enzoocorte/Planta-Ultrafiltracion/00_General_y_P_ID_Planta/01_Estructura_y_Montaje_Filtro/tanque permeado.jpg

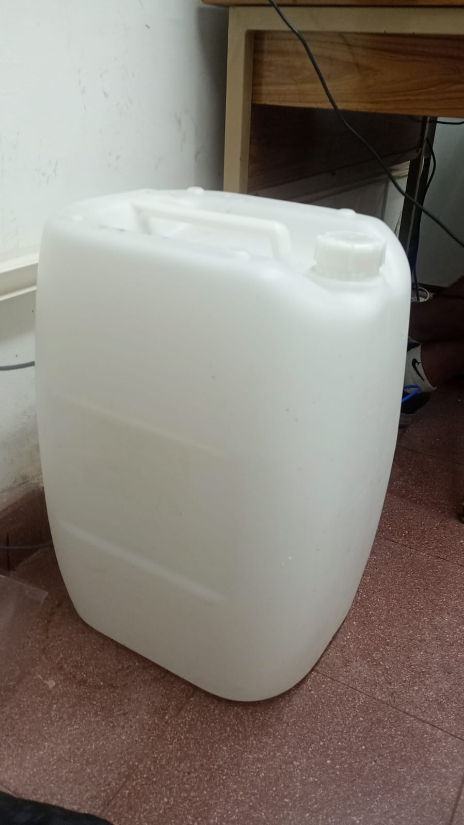
00_General_y_P_ID_Planta/01_Estructura_y_Montaje_Filtro/tanque permeado.jpg
