enzoocorte/Planta-Ultrafiltracion/03_Hito3_Reactor_Sedimentador_Agitador/03_Compras_y_Ferreteria_Hidraulica/Lista_Ferreteria_Mecanica_y_Electrica_Agitador_Hito3.md

# 🛒 LISTA MAESTRA CONSOLIDADA DE COMPRAS Y TALLER (PLANTEL COMPLETO)
## Hito 0, 1, 2 y 3: Skid 45x45, Hidráulica FX100, Sedimentador Inox y Control ESP32
**Proyecto:** Planta Piloto de Ultrafiltración UNSa — Meta: Puesta a punto 15 de Noviembre 2026  
**Referencia:** Auditoría Técnica Cruzada Antigravity & Argon (Octubre 2026)  
**Destinatarios:** Ing. Enzo Corte, Antonella Guitián & Owen Cañizares

---

## 🎯 1. Objetivo del Documento
Esta es la **hoja de ruta definitiva para compras y mostrador**. Contiene todos los componentes mecánicos, hidráulicos, eléctricos y de taller necesarios para armar el Skid de 45x45x45 cm, perforar el sedimentador de acero inoxidable AISI 304 e interconectar el cartucho Fresenius FX100 sin faltantes ni incompatibilidades de rosca.

---

## 📋 2. Planilla Maestra para Mostrador (Imprimir / Llevar al Celular)

### 🔩 SECCIÓN 1: Estructura del Maletín Skid (450 x 450 x 450 mm)
| Ítem | Componente | Cant. | Especificación Técnica | Dónde Comprar |
| :--- | :--- | :---: | :--- | :--- |
| **1.1** | **Base de madera marina** | 1 | Multilaminado fenólico marino **18 mm** cortado a **450 x 450 mm** (barnizado antihumedad). | Maderera / Easy |
| **1.2** | **Tubo estructural cuadrado** | 4 m | Tubo de acero al carbono **20 x 20 mm (chapa 1.2 mm)** para el marco cúbico. | Metalúrgica / Hierros Salta |
| **1.3** | **Chapa perforada** | 2 paños | Chapa de hierro o aluminio de **1.2 a 1.5 mm** perforada decorativa (450 x 450 mm). | Metalúrgica / Zinguería |
| **1.4** | **Puerta frontal transparente** | 1 placa | **Policarbonato compacto de 3 o 4 mm** (450 x 450 mm). *(No acrílico: no se quiebra por vibración)*. | Vidriería / Plásticos Salta |
| **1.5** | **Ferretería de puerta** | 1 juego | 2 bisagras metálicas tipo libro chicas + **1 traba rápida tipo baúl (*toggle latch*)**. | Ferretería industrial |
| **1.6** | **Tacos silentblock NEMA 34** | 4 | Tacos antivibratorios cilíndricos de goma **M5 macho-hembra** (20 mm alto). | Bulonera Salta |
| **1.7** | **Patas de goma del maletín** | 4 | Regatones o patas de goma con tornillo central (Ø 25–30 mm). | Bulonera Salta |
| **1.8** | **Manija de transporte** | 1 | Manija metálica rebatible robusta de maletín industrial. | Ferretería / Herrajes |
| **1.9** | **Abrazaderas del FX100** | 2 | Abrazaderas acolchadas con goma tipo clamps de **2" (50–55 mm)** para caño. | Sanitarios / Ferretería |
| **1.10**| **Tabique divisor interno** | 1 placa | Placa fenólica de 10-12 mm o PVC espumado (430 x 430 mm) para separar zona seca/húmeda. | Maderera / Taller |

---

### 🚰 SECCIÓN 2: Conexiones Hidráulicas, Válvulas y Dializador FX100
> [!IMPORTANT]
> **Llevar al mostrador:** El cartucho FX100, los manómetros P1/P2 y el caudalímetro YF-S401 para presentar las roscas y espigas en la mano.

| Ítem | Componente | Cant. | Especificación Técnica | Función en Planta |
| :--- | :--- | :---: | :--- | :--- |
| **2.1** | **Válvula de corte succión** | 1 | Válvula esférica de **1/2" Macho-Hembra (o H-H)** en bronce o acero inox. | Se enrosca al pasamuros del sedimentador para cortar flujo y desacoplar sin vaciar 25L. |
| **2.2** | **Pasamuros sedimentador** | 1 | Pasamuros de bronce o acero inox de **1/2"** con tuerca hexagonal ancha con brida. | Toma de succión en pared cilíndrica del sedimentador. |
| **2.3** | **Pasamuros de panel skid** | 3 | Pasamuros hidráulicos/neumáticos roscados de **1/4" BSP** (1 para retorno, 2 para panel skid). | Traspaso estanco de mangueras a través de las paredes. |
| **2.4** | **Pasamuros bidón permeado** | 1 | Pasamuros plástico de **1/2"** con canilla plástica o metálica de **1/2"**. | Salida dispensadora de agua tratada en bidón inferior. |
| **2.5** | **Niples entrerrosca** | 2 | Niple hexagonal de bronce de **1/4" Macho - 1/4" Macho**. | **Crítico:** Une la Tee hembra de P2 directo a la válvula de aguja hembra. |
| **2.6** | **Tees para manómetros** | 2 | Tee de bronce de **1/4" Hembra - Hembra - Hembra**. | Intercala los manómetros P1 y P2 en la línea de flujo. |
| **2.7** | **Bujes de reducción** | 2 | Buje de reducción de bronce de **1/2" Macho a 1/4" Hembra**. | Reducción inmediata a la salida del cabezal peristáltico. |
| **2.8** | **Bujes de manómetros** | 2 | Buje de reducción de **1/4" Macho a 1/8" Hembra** *(solo si los manómetros son rosca 1/8")*. | Adaptación según rosca inferior del manómetro Bourdon. |
| **2.9** | **Válvula de aguja** | 1 | Válvula de aguja de **1/4" Hembra - Hembra** (latón o acero inox). | Control fino de contrapresión y ajuste exacto de TMP en retentado. |
| **2.10**| **Espigas para manguera 1/4"** | 6 | Espiga de bronce rosca **1/4" Macho** para manguera de 6 mm int. | Conexión de tees, pasamuros y válvula de aguja. |
| **2.11**| **Espigas para manguera 1/2"** | 3 | Espiga de bronce rosca **1/2" Macho** para manguera de 12 mm int. | Conexión en válvula de corte y succión de bomba. |
| **2.12**| **Uniones dobles espiga** | 2 | Unión doble espiga-espiga de bronce o plástico de **1/2" (12 mm)**. | Empalme del tramo de silicona peristáltica con manguera de línea. |
| **2.13**| **Manguera bomba peristáltica**| 1 m | Tubo de **Silicona curada al platino o Norprene Ø int. 12 mm (pared ≥ 3 mm)**. | Tramo interno de rodillos MBP-2000 *(prohibido PVC cristal aquí)*. |
| **2.14**| **Manguera de línea 1/2"** | 2 m | Manguera atóxica flexible de PVC cristal o silicona Ø int. **12 mm**. | Succión desde sedimentador al maletín. |
| **2.15**| **Manguera de línea 1/4"** | 4 m | Manguera atóxica de silicona o PVC cristal Ø int. **6 mm**. | Circuito de permeado, retentado y manómetros. |
| **2.16**| **Manguera acople FX100** | 0.5 m | Tubo de silicona de **Ø int. 10 a 12 mm**. | Calza sobre los picos lisos Hansen (12 mm) del dializador FX100. |
| **2.17**| **Venteo/Tapón FX100** | 1 | Tapón de 1/2" o valvulita esférica miniatura de 1/4" con reducción. | Clausura/purga de aire del 2do puerto lateral de dializado del FX100. |
| **2.18**| **Sellador de roscas** | 1 pomo | **Sellador anaeróbico para roscas (Trabasil RM2 / Loctite 542 / Hidro 3)**. | Permite orientar P1 y P2 hacia el frente con cero goteo. |
| **2.19**| **Cinta teflón industrial** | 2 rollos| Cinta de teflón de alta densidad (carrete amarillo o rosa). | Sellado complementario de roscas cónicas. |
| **2.20**| **Abrazaderas y precintos** | 1 pack | 10 abrazaderas cremallera 1/2", 6 abrazaderas 1/4" + **10 precintos plásticos 100x2.5mm** (para YF-S401). | Sujeción estanca sin quebrar picos plásticos. |

---

### 🌪️ SECCIÓN 3: Tren Mecánico del Sedimentador (Hito 3)
| Ítem | Componente | Cant. | Especificación Técnica | Dónde Comprar |
| :--- | :--- | :---: | :--- | :--- |
| **3.1** | **Chumacera con Brida** | 1 | **Chumacera tipo KFL08 (para eje Ø 8 mm)** con 2 prisioneros allen. | Rodamientos Salta / Ituzaingó |
| **3.2** | **Acoplamiento Elástico** | 1 | Acople tipo spider / mandíbula **8 mm a 8 mm** (o según eje motor). | Rodamientos Salta / Mercado Libre |
| **3.3** | **Varilla de Eje Agitador** | 1 m | **Varilla redonda calibrada de Acero Inox AISI 304 Ø 8 mm (tolerancia h9)**. | Bulonera Salta / Aceros |
| **3.4** | **Placa Sándwich de Grilón** | 1 placa | Placa de **Grilón / Nylon de 120 x 120 mm (espesor 8 a 10 mm)**. | Bulonera Salta / Plásticos |
| **3.5** | **Separadores de Torreta** | 4 | Separadores o espárragos roscados **M6 x 50 mm** de acero cincado o inox. | Bulonera Salta |
| **3.6** | **Tornillería Inox Tapa** | 1 juego | Tornillos M5 y M6 con arandelas planas, growers y tuercas autofrenantes en AISI 304. | Bulonera Salta |
| **3.7** | **Arandelas respaldo pasamuros**| 4 | Arandelas planas de **Acero Inox AISI 304 de ala ancha** para bulón de 1/2" y 3/4". | Bulonera Salta |
| **3.8** | **Plancha de goma para juntas** | 1 retazo| Goma de **Silicona Sanitaria o EPDM espesor 3 mm** (para cortar juntas curvas). | Bulonera Salta / Sanitarios |

---

### ⚡ SECCIÓN 4: Electricidad, Control e Inmunidad EMI
| Ítem | Componente | Cant. | Especificación Técnica | Dónde Comprar |
| :--- | :--- | :---: | :--- | :--- |
| **4.1** | **Gabinete estanco para lógica**| 1 | Caja estanca plástica IP65 de **150 x 110 x 70 mm** con tapa transparente/opaca. | Casa de Electricidad Salta |
| **4.2** | **Fuente conmutada DC** | 1 | Fuente switching **12V DC (8 a 10A)** tipo panel con bornera. | Electrónica / Megatone |
| **4.3** | **Driver MOSFET Agitador** | 1 | Módulo **BTS7960 (IBT-2 de 43A)** con disipador macizo. | Electrónica / Mercado Libre |
| **4.4** | **Conector circular industrial** | 1 par | Conector tipo aviación **GX16 de 4 pines** (1 chasis hembra + 1 aéreo macho). | Electrónica Salta |
| **4.5** | **Cable tipo taller envainado** | 3 m | Manguera redonda flexible negra de **4 x 1.0 mm² o 4 x 1.5 mm²**. | Casa de Electricidad Salta |
| **4.6** | **Entrada 220V de chasis** | 1 | Conector tipo interlock C14 con **portafusible y tecla luminosa bipolar**. | Electrónica Salta |
| **4.7** | **Portafusible secundario 24VAC**| 1 | Portafusible aéreo o de chasis + **2 fusibles de vidrio de 6A o 8A (lentos / Time-Lag)**. | Electrónica Salta |
| **4.8** | **Prensaestopas de panel** | 6 | Prensaestopas plásticos de nylon: **2x PG7** (sensores tapa) + **4x PG9/PG11** (caja estanca). | Casa de Electricidad Salta |
| **4.9** | **Capacitor VIN ESP32** | 1 | Capacitor electrolítico de **470 µF / 25V** (reservorio anti-brownout Wi-Fi). | Casa de Electrónica |
| **4.10**| **Capacitor entrada BTS7960** | 1 | Capacitor electrolítico de **1000 µF / 25V** (absorción de picos del agitador). | Casa de Electrónica |
| **4.11**| **Capacitores cerámicos anti-ruido**| 3 | Capacitores cerámicos multicapa de **100 nF (0.1 µF / 50V)** (motor, boya, VIN). | Casa de Electrónica |
| **4.12**| **Resistencias de protección** | 2 c/u | Resistencia de **2.2 kΩ** (pull-up boya) + Resistencia de **470 Ω** (en serie a GPIO 32). | Casa de Electrónica |

---

### 🛠️ SECCIÓN 5: Herramientas Críticas de Taller (Para Inox 304)
| Ítem | Herramienta | Cant. | Especificación Técnica | Uso Exclusivo |
| :--- | :--- | :---: | :--- | :--- |
| **5.1** | **Mecha escalonada de Cobalto** | 1 | **Mecha escalonada cónica HSS-Co (M35 con 5% Cobalto) de 4 a 22 mm**. | Perforación perfecta y sin rebaba del Inox 304 a 350-400 RPM. |
| **5.2** | **Mecha guía de Cobalto** | 1 | Mecha helicoidal HSS-Co de **Ø 3.2 mm o 4.0 mm**. | Agujero guía previo al escalón en la chapa del sedimentador. |
| **5.3** | **Aceite de corte pesado** | 1 frasco| Aceite para roscado/corte de metales pesados o aceite de motor SAE 30/40. | Lubricación constante del filo en inox (evita vitrificación). |

---

## 📍 3. Comercios Recomendados en Salta Capital

1. **Bulonería y Plásticos Técnicos (Grilón, bulonería inox AISI 304, silentblocks, mecha cobalto):**
   * **Bulonera Salta:** Av. San Martín / Av. Chile.
2. **Rodamientos y Mecánica (Chumacera KFL08, acople flexible, varilla calibrada 8 mm):**
   * **Rodamientos Salta:** Av. San Martín y Pellegrini.
   * **Casa del Rodamiento:** Calle Ituzaingó y Pellegrini.
3. **Hidráulica y Sanitarios (Válvulas esféricas, válvula de aguja, tees de bronce, pasamuros, Trabasil):**
   * **Sanitarios Pieve / Sanitarios San Martín / Ferretería Central:** Av. San Martín / Pellegrini.
4. **Electricidad y Gabinetes (Cajas IP65 Roker/Genrod, térmicas, prensaestopas, cable TPR):**
   * **Electro Salta / Megatone Materiales Eléctricos:** Calle Pellegrini / Urquiza.
5. **Componentes Electrónicos (BTS7960, GX16, capacitores, fusibles):**
   * **Microelectrónica Salta / Megatone Componentes:** Calle Alvarado / Urquiza.
