enzoocorte/Planta-Ultrafiltracion/Archivado/Prompts_Auditorias_y_Sesiones/RESPUESTA_AUDITORIA_ARGON_SKID_Y_COMPRAS.md

# 📋 DICTAMEN OFICIAL DE ARGON: AUDITORÍA TÉCNICA DE CIERRE (DFM/DFA, SKID 45x45 Y COMPRAS)
**De:** Argon (AI Senior Technical Peer Reviewer — Mecatrónica, Hidráulica y Procesos)  
**Para:** Ing. Enzo Corte (Codirector) & Antigravity (Ingeniero Líder)  
**Fecha:** 27 de Octubre de 2026  
**Proyecto:** Planta Piloto de Ultrafiltración FX100 & Reactor Sedimentador (UNSa 2026)  
**Estado del Dictamen:** **APROBADO CON OBSERVACIONES CRÍTICAS DE INTERFAZ Y DIMENSIONAMIENTO**

---

## 📌 RESUMEN EJECUTIVO Y VEREDICTO
Argon avaló plenamente la arquitectura modular (3 módulos) y la postergación de la celda de carga HX711 para garantizar la puesta a punto a mediados de noviembre. Identificó **6 puntos ciegos críticos de taller e interfaces hidráulicas/eléctricas** que fueron incorporados de inmediato a la orden de compra y diseño estructural:

1. **Tabique vertical en el Skid (45x45x45 cm):** Separación física entre zona húmeda frontal (60%) y zona seca ventilada trasera (40%). El DM860 y la fuente de 12V van ventilados contra la chapa perforada, evitando su encierro térmico.
2. **Puertos del Dializador Fresenius FX100:** Los puertos son de Ø 12 mm (1/2"); se requiere manguera de silicona de 12 mm y reducciones a 1/4", más tapón/válvula de venteo para el segundo puerto lateral de dializado.
3. **Conexión del Caudalímetro YF-S401:** Posee picos lisos de 6 mm (no roscas BSP); se conecta con manguera de 1/4" y precintos plásticos (no abrazaderas metálicas que rajan el plástico).
4. **Válvula de corte en succión del sedimentador:** Llave esférica de 1/2" inmediatamente tras el pasamuros para desacoplar el maletín sin vaciar los 25L.
5. **Niple de 1/4" Macho-Macho:** Necesario para vincular la Tee hembra de P2 con la válvula de aguja hembra.
6. **Manguera peristáltica:** Prohibido PVC cristal en el cabezal MBP-2000; tubo elástico de silicona gruesa (pared ≥ 3 mm) o Norprene.

---

*(Texto completo del dictamen archivado para trazabilidad histórica de tesis en el repositorio).*
