enzoocorte/Planta-Ultrafiltracion/Curso_Congreso_Quimica/GUIA_LABORATORIO_IMPRIMIR_CONEIQ_2026.docx

XXIX CoNEIQ Salta 2026 — Taller de Tratamiento de Aguas

GUÍA RÁPIDA DE OPERACIÓN EN MESADA (VASOS DE 1000 mL / 100% AGUA DE RED)
Audiencia: 30 Inscriptos (5 Brigadas de 6 Alumnos + Vaso Control Docente) | Docentes: Dr. Emilio Almazán & Ing. Enzo Corte

1. CHECKLIST PREVIO AL ENSAYO (100% AGUA DE RED — SIN DESTILADA)

- Rotular 6 vasos de precipitado de 1000 mL (1 L): V1 (Docente), V2 a V4 (Baja Turbidez) y V5 a V6 (Alta Turbidez). Cargar con 1000 mL de agua de red c/u.
- Pesar y dispersar arcilla tamizada (<45 um): 1.00 g en V2, V3, V4 (Baja Turbidez, ~120 NTU) | 4.00 g en V1, V5, V6 (Alta Turbidez, ~450 NTU).
- Preparar Stock de Sulfato al 1.0% p/v en agua de red: Disolver 2.50 g de sulfato puro en 250 mL de agua de red (10 mg/mL).
- Biocoagulante de Penca (Hidrogel suave): Hidratar cubos 15 min en agua y dar 6 pulsos suaves de 2 s. Pesar en balanza: 0.50 g (V3), 1.80 g (V4) y 0.60 g (V6).
- Acondicionar Turbidímetro HANNA: verificar cubetas limpias con pañuelo tissue y patrones a mano.

2. CUADRO MAESTRO DE DOSIFICACIÓN (VASOS DE 1000 mL)

Vaso | Asignación | Matriz (1 L) | Tratamiento | Dosis Efectiva | ¿Cuánto agregar al Minuto 0?
V1 | Docentes (Control) | 1000 mL + 4.0 g arcilla | Blanco (Control) | 0 mg/L | Nada (0 mL)
V2 | Brigada 1 (6 alumnos) | 1000 mL + 1.0 g arcilla | Sulfato de Aluminio | 20 mg/L | 2.0 mL de stock 1% (2000 uL)
V3 | Brigada 2 (6 alumnos) | 1000 mL + 1.0 g arcilla | Penca (Opuntia) | 0.5 g/L | 0.50 g de hidrogel fresco
V4 | Brigada 3 (6 alumnos) | 1000 mL + 1.0 g arcilla | Penca (SOBREDOSIS) | 1.8 g/L | 1.80 g de hidrogel (¡Visual!)
V5 | Brigada 4 (6 alumnos) | 1000 mL + 4.0 g arcilla | Sulfato de Aluminio | 40 mg/L | 4.0 mL de stock 1% (4000 uL)
V6 | Brigada 5 (6 alumnos) | 1000 mL + 4.0 g arcilla | Penca (Opuntia) | 0.6 g/L | 0.60 g de hidrogel fresco

3. CRONOGRAMA OPERATIVO DE CORRIDA (16 MINUTOS EXACTOS)

• MIN 00:00 - 01:00 (150 RPM — MEZCLA RÁPIDA): Encender las 6 paletas. Las brigadas agregan SIMULTÁNEAMENTE sus reactivos. Dispersión macromolecular y neutralización instantánea.

• MIN 01:00 - 06:00 (25-30 RPM — MEZCLA LENTA): Bajar velocidad a 25-30 RPM. Floculación ortocinética: observar macroflóculos en V3 y V6 vs flóculos densos en V2 y V5, y la opacidad lechosa en V4.

• MIN 06:00 - 16:00 (0 RPM — SEDIMENTACIÓN ESTÁTICA): Cortar motor a 0 RPM. Subir suavemente las paletas. Reposo estático durante 10 minutos (precipitación según Ley de Stokes).

• MIN 16:00 (MUESTREO Y MEDICIÓN CON TURBIDÍMETRO HANNA): Tomar muestra a 2 cm de profundidad con pipeta/jeringa (no tocar el fondo). Limpiar celda con tissue, alinear muesca y presionar READ.

4. PLANILLA DE REGISTRO EN MESADA (PARA COMPLETAR A MANO DURANTE EL ENSAYO)

Vaso | Asignación | Tratamiento | Dosis | Turb. Inicial (Ti) | Turb. Final (Tf) | Remoción RT % | pH Inic. | pH Fin. | Aspecto Visual
V1 | Docentes | Blanco (Control) | 0 mg/L
V2 | Brigada 1 | Sulfato Aluminio | 20 mg/L
V3 | Brigada 2 | Penca (Opuntia) | 0.5 g/L
V4 | Brigada 3 | Penca SOBREDOSIS | 1.8 g/L
V5 | Brigada 4 | Sulfato Aluminio | 40 mg/L
V6 | Brigada 5 | Penca (Opuntia) | 0.6 g/L

5. PREGUNTAS DISPARADORAS Y CHULETA TEÓRICA PARA EL DOCENTE

• ¿Por qué V4 (sobredosis en baja turbidez) clarificó mucho peor que V3?: Impedimento estérico y saturación coloidal: el exceso de mucílago recubre individualmente cada partícula de arcilla. Al no haber sitios activos libres, las partículas se repelen y no forman puentes, manteniéndose en suspensión.

• ¿Por qué el sulfato bajó el pH y la penca no?: El catión Al3+ se hidroliza liberando iones H+ al medio (consume alcalinidad natural del agua). La penca actúa como biopolímero por puente molecular sin alterar la química ácida-base (pH neutro).

• ¿Por qué prehidratamos la penca 15-20 min?: Permite el hinchamiento osmótico (swelling) del mucílago, relajando las cadenas para extraer el hidrogel íntegro con pulsos suaves sin romperlas covalentemente por alto cizallamiento.

• Acondicionamiento para el Jueves (Ultrafiltración): Sifonar con pipeta 600 a 700 mL de sobrenadante de V2, V3 y V5 + una alícuota de agua cruda (400 NTU). Guardar en botellas rotuladas para alimentar la Planta FX100.
