enzoocorte/Planta-Ultrafiltracion/Curso_Congreso_Quimica/PLANIFICACION_CURSO_CONEIQ_2026.docx

XXIX CoNEIQ Salta 2026 — Congreso Nacional de Estudiantes de Ingeniería Química

PLANIFICACIÓN INTEGRAL DE CURSO / TALLER TEÓRICO-PRÁCTICO
"Tratamiento Avanzado y Sustentable de Aguas: Sinergia entre Biocoagulantes Naturales (Opuntia ficus-indica) y Separación por Membranas de Ultrafiltración (UF)"

Docentes / Disertantes: Dr. Ing. Emilio Almazán & Ing. Enzo Corte (UNSa - INIQUI - CONICET)
Audiencia: 30 Estudiantes inscriptos (5 Brigadas de 6 alumnos + 1 Vaso Control Docente)
Recursos: 6 Vasos de precipitado de 1000 mL (1 L) | 100% Agua de Red local (sin requerimiento de agua destilada)

1. RESUMEN EJECUTIVO Y DINÁMICA DE COORDINACIÓN

- ¿Por qué 3 horas el Miércoles?: 3 horas completas son indispensables. Con 30 estudiantes divididos en brigadas, el trabajo involucra conformación de grupos, pesada y dispersión individual de arcilla en los vasos de 1 Litro, extracción suave del hidrogel de penca y stock de sulfato, corrida del Jar Test (16 min), nefelometría Hanna, pH, carga colaborativa de datos y envasado de sobrenadantes para el jueves.
- ¿Cómo estructurar el Jueves (3 h)?: División pedagógica 50% Aula / 50% Planta: Bloque 1 (14:00 - 15:15) Clase magistral de Membranas con el Dr. Emilio Almazán (fuerzas impulsoras, analogía Darcy-Ohm, Hermia, Fibra Hueca vs Plana). Bloque 2 (15:15 - 17:00) Operación en Planta Piloto FX100 con Enzo Corte, filtrando primero el agua clarificada con penca (TMP plana y estable) y luego el agua cruda (salto de presión por colmatación), retrolavado y cálculo de FRR%.

2. CRONOGRAMA MAESTRO DEL CURSO

- Martes 20/10 (14:00 - 17:00): Problemática hídrica en zonas áridas y tratamientos convencionales. Actividad grupal de diagnóstico. Introducción a biopolímeros naturales.
- Miércoles 21/10 (08:00 - 11:00): Laboratorio Experimental de Clarificantes. Preparación de matrices acuosas de 1 L en agua de red, extracción de Opuntia ficus-indica por bajo cizallamiento, corrida del Jar Test de 16 minutos, medición con turbidímetro Hanna y almacenamiento de muestras.
- Jueves 22/10 (14:00 - 17:00): Teoría de Procesos de Separación por Membranas (Emilio Almazán) y Taller Experimental en Planta Piloto FX100 con SCADA Web / ESP32 (Enzo Corte).

3. LABORATORIO DE CLARIFICACIÓN: JAR TEST EN VASOS DE 1000 mL (MIÉRCOLES)

3.1. ¿Por qué hacemos la Prehidratación Estática de la Penca (15-20 min)?

FUNDAMENTO REOLÓGICO: En el cladodio fresco poscosecha, el mucílago está confinado en conductos laticíferos y células mucilaginosas en forma de gel semiseco concentrado. Al sumergir los dados en agua durante 15-20 min ocurre un hinchamiento osmótico (swelling) con ganancia de masa del ~50%. Esto relaja las cadenas macromoleculares de ácido galacturónico de las paredes celulares de celulosa y lignina, permitiendo que bastaran 6 pulsos suaves de 2 segundos para liberar el hidrogel íntegro. Si se licuara en seco o sin prehidratar, se requeriría un cizallamiento violento que fracturaría covalentemente las cadenas (despolimerización mecánica), arruinando su poder floculante.

3.2. Cuadro Comparativo: Sulfato de Aluminio vs. Penca (Opuntia ficus-indica)

Criterio Técnico | Sulfato de Aluminio Puro [Al2(SO4)3] | Penca de Tuna (Opuntia ficus-indica)
Mecanismo Dominante | Neutralización de carga y barrido: Cationes Al3+ comprimen doble capa y precipitan como hidróxido amorfo Al(OH)3. | Puente polimérico (Bridging): Cadenas largas macromoleculares con grupos -OH y -COO- que atrapan coloides simultáneamente.
Efecto sobre el pH | Ácido (Delta pH aprox -1.0): Se hidroliza liberando iones H+ y consume la alcalinidad natural del agua. | Neutro (Delta pH aprox 0): Polielectrolito de origen vegetal; no altera el equilibrio ácido-base del afluente.
Naturaleza del Lodo | Químico, voluminoso, gelatinoso, de difícil deshidratación física y con trazas de aluminio neurotóxico. | Biológico, compacto, de deshidratación rápida, 100% biodegradable y compostable para suelos agrícolas.
Efecto de Sobredosis | Inversión de carga positiva (+): Vuelve a dispersar los coloides y acidifica peligrosamente el agua. | Impedimento estérico: El mucílago satura cada coloide individualmente, impidiendo que formen puentes. Deja agua turbia y con DQO soluble.
Salinidad / TDS | Aporta aniones sulfato (SO4=) y aumenta los sólidos disueltos totales y conductividad. | No aporta sales minerales; mantiene la conductividad basal del agua de red.

3.3. Cuadro Maestro de Dosificación en Vasos de 1000 mL (1 Litro de Agua de Red)

Audiencia de 30 estudiantes organizada en 5 brigadas activas de 6 alumnos + 1 Vaso Control Docente. El ensayo se realiza 100% en agua de red.

Vaso | Asignación | Matriz (1 L) | Tratamiento | Dosis Efectiva | ¿Cuánto agregar al Min 0?
V1 | Docentes (Control) | 1000 mL + 4.0 g arcilla (~450 NTU) | Blanco (Control) | 0 mg/L | Nada (0 mL)
V2 | Brigada 1 (6 alumnos) | 1000 mL + 1.0 g arcilla (~120 NTU) | Sulfato de Aluminio | 20 mg/L | 2.0 mL stock 1% (2000 uL)
V3 | Brigada 2 (6 alumnos) | 1000 mL + 1.0 g arcilla (~120 NTU) | Penca (Opuntia) | 0.5 g/L | 0.50 g de hidrogel fresco
V4 | Brigada 3 (6 alumnos) | 1000 mL + 1.0 g arcilla (~120 NTU) | Penca (SOBREDOSIS) | 1.8 g/L | 1.80 g de hidrogel (¡Visual!)
V5 | Brigada 4 (6 alumnos) | 1000 mL + 4.0 g arcilla (~450 NTU) | Sulfato de Aluminio | 40 mg/L | 4.0 mL stock 1% (4000 uL)
V6 | Brigada 5 (6 alumnos) | 1000 mL + 4.0 g arcilla (~450 NTU) | Penca (Opuntia) | 0.6 g/L | 0.60 g de hidrogel fresco

IMPACTO VISUAL EN EL LABORATORIO: Al ubicar la sobredosis de penca en Baja Turbidez (Vaso 4), se genera un contraste pedagógico instantáneo contra el Vaso 3 (ambos parten del agua con 120 NTU): mientras V3 queda cristalino (<3 NTU), V4 queda notablemente lechoso y turbio debido a la reestabilización coloidal.

3.4. Cronómetro Operativo de Corrida (Ciclo de 16 Minutos)

- Min 00:00 - 01:00 (Mezcla Rápida a 150 RPM): Encender las paletas. Las brigadas agregan simultáneamente los reactivos en V2 a V6. Dispersión macromolecular y desestabilización instantánea.
- Min 01:00 - 06:00 (Mezcla Lenta a 25-30 RPM): Reducir agitación. Crecimiento ortocinético de macroflóculos por colisiones de Smoluchowski sin superar la tensión de corte que rompería los flóculos.
- Min 06:00 - 16:00 (Sedimentación Estática a 0 RPM): Apagar el motor y subir suavemente las paletas. Reposo estático de 10 minutos (precipitación por Ley de Stokes).
- Min 16:00 (Muestreo y Nefelometría Hanna): Tomar muestra a 2 cm de profundidad con pipeta/jeringa (sin perturbar el sedimento del fondo). Medir turbidez en turbidímetro Hanna HI93703 y registrar pH.
- Acondicionamiento para el Jueves: Sifonar con pipeta 600 a 700 mL de sobrenadante de V2, V3 y V5, y guardar una muestra de agua cruda (400 NTU) en botellas rotuladas para la ultrafiltración.

4. PROCESOS DE MEMBRANA Y PLANTA PILOTO DE ULTRAFILTRACIÓN (JUEVES)

4.1. Marco Teórico: Darcy, Resistencias y Tipos de Módulo

La Ley de Darcy describe el flujo capilar en base a resistencias hidráulicas en serie:

J = Qp / Am = TMP / (mu(T) * R_total) [LMH o m/s]

Donde: R_total = Rm + R_torta + R_irrev

- Analogía con la Ley de Ohm: El flujo J es la corriente (I); la TMP es el voltaje impulsor (Delta V); la viscosidad mu(T) es la fricción térmica del fluido; y las resistencias hidráulicas R representan la oposición eléctrica.
- Desglose de Resistencias: Rm es la resistencia intrínseca del material limpio (Helixone). R_torta es la capa reversible de lodo sobre la superficie capilar (se expulsa con retrolavado). R_irrev es el bloqueo interno en la garganta del poro (exige lavado químico CIP).

4.2. Módulo de Fibra Hueca (FX100) vs. Membrana Plana (Placa)

- Densidad de Empaque (m2/m3): La Fibra Hueca FX100 compacta miles de capilares alcanzando >10.000 m2/m3 (2.2 m2 en un cartucho cilíndrico de mano). En Membrana Plana la densidad es de apenas 100-400 m2/m3, requiriendo un bastidor voluminoso.
- Capacidad de Retrolavado (Backwashability): La Fibra Hueca tolera pulsos a presión inversa (desde el permeado hacia el lumen) expandiendo el capilar y desprendiendo la torta sin dañarse. La Membrana Plana no tolera presión inversa (se despega o desgarra de su soporte poroso) y depende de cizallamiento tangencial superficial.
- Canales Hidrodinámicos: La fibra hueca posee canales tubulares lisos y uniformes. La membrana plana requiere mallas plásticas separadoras (feed spacers) que inducen turbulencia pero acumulan biomasa en sus cruces.

4.3. ¿Por qué Bomba Peristáltica (NEMA 34) y no una Bomba Centrífuga?

Parámetro Técnico | Bomba Peristáltica (NEMA 34 + DM860) | Bomba Centrífuga Barata
Principio de Impulsión | Desplazamiento positivo determinístico: Cada paso desplaza un volumen exacto fijo (mL/rev). | Cinética hidrodinámica: El caudal depende de la contrapresión del sistema (curva H-Q).
Comportamiento ante Fouling | Mantiene caudal constante (Q = cte): Al subir la resistencia de la membrana, eleva suavemente la presión permitiendo modelar Darcy en tiempo real. | El caudal se desploma: Al subir la resistencia, la centrífuga se corre a caudal casi nulo (Q -> 0) y no permite modelar el ensuciamiento.
Cizallamiento sobre Flóculos | Muy bajo cizallamiento (20 a 80 RPM): Compresión ondulante suave que no rompe los macroflóculos de penca. | Cizallamiento violento (2800 RPM): Los álabes trituran los flóculos en micropartículas que taponan los poros capilares.
Aislamiento Sanitario | Estanqueidad absoluta: El agua solo toca la manguera de silicona médica; sin sellos mecánicos ni aceites. | Posee sellos mecánicos con fugas potenciales, desgaste por arcillas y lubricantes contaminantes.
Reversibilidad de Flujo | Invierte el giro en milisegundos por código para retrolavado o purga de cabezales. | No puede girar en reversa de forma operativa.

4.4. Secuencia Operativa en Planta Piloto FX100 (Inversión Didáctica)

ORDEN RIGUROSO DE FILTRACIÓN: Para resguardar el cartucho FX100 y demostrar didácticamente el pretratamiento:
1. Línea Base (CWF): Agua limpia de red para medir Rm intrínseca.
2. Paso A (PRIMERO): Filtrar Agua Clarificada con Opuntia (<5 NTU). La TMP se mantiene baja y constante.
3. Paso B (SEGUNDO): Filtrar Agua Cruda Directa (400 NTU). Se muestra el disparo violento de presión y colapso de flujo.
4. Paso C: Retrolavado hidráulico (60 s) con agua limpia y cálculo de FRR%.

4.5. Fouling Reversible vs. Irreversible y Cálculo del FRR%

FRR (%) = ( J_limpio,post-lavado / J_limpio,inicial ) * 100

- Interpretación de los Flujos: Comparamos agua limpia de red en la membrana virgen (J_inicial) contra agua limpia de red tras el retrolavado (J_post). Como la membrana usada nunca queda más limpia que de fábrica, siempre J_post <= J_inicial.
- Interpretación del Índice: Si FRR >= 90-95%, el ensuciamiento fue reversible (torta superficial de Opuntia fácilmente expulsable). Si FRR < 65%, existió bloqueo irreversible en garganta de poros (comportamiento del agua cruda directa).

5. INVENTARIO DE MATERIALES Y EQUIPAMIENTO (100% AGUA DE RED)

- Materiales de Vidrio y Reactivos: 6 vasos de precipitado de 1000 mL, 200 g de arcilla tamizada (<45 um), 250 g de sulfato de aluminio puro (Química Valfer), 3 cladodios frescos de penca, 30 L de agua de red.
- Instrumental Analítico: Turbidímetro Hanna HI93703 con patrones y celdas limpias, peachímetro, minipimer manual, balanzas granatarias y analíticas, pipetas graduadas de 5 y 10 mL con propipetas.
- Planta de Ultrafiltración: Bastidor modular con cartucho Fresenius CorDiax FX100 (Helixone, 2.2 m2), bomba peristáltica MBP-2000 con NEMA 34 y DM860, manómetros de glicerina calibrados (0-1 bar) y servidor Web SCADA en ESP32.
