enzoocorte/Planta-Ultrafiltracion/ESTRUCTURA PARA EL FILTRO/Estructura para el modulo de ultrafiltracion.docx

Estructura para el modulo de ultrafiltracion:

La estructura va a estar divida en 3 modulos:

1) MODULO DE SEDIMENTADOR
- Soporte del tanque sedimentador:
- medidas de las patitas del mismo 34 cm – 30 cm – 29/30 cm – 33 cm
- Tanque/tacho sedimentador:
- Altura 43 cm
- Caño/Valvula de alimentación desde la base 5 cm
- Diametro = ¿
- Altura parte cónica = ¿
- Modificaciones en tapa: Perforación del costado para el retrolavado – perforación en el medio para la paleta del tamaño del diámetro del acople– desoldar la manija y hacerla con mas altura para que tenga espacio donde va a ir el motorcito por si queremos sacarlo y volerlo a poner
- Paleta giratoria:
- Altura del vastago 32 cm
- Radio 2 mm
- Diámetro 4 mm
- Motorcito – radio 3 mm (con plástico) sin plástico diámetro 2 mm
- Acople de aluminio de 2 mm a 4-6 mm
- Vastago tiene la punta con rosca (se debe cortar o se puede buscar un acople que se pueda enroscar a esta?)

El modulo sedimentador estaría al costado del filtro se conectaría por las mangueras

2) MODULO DEL FILTRO
- Caja cuadrada 45 cm x 45 cm x 45 cm
- Laterales de los costados y del fondo tendría chapa perforada
- Lateral de adelante tendría una puerta
- Base chapa solida
- Techo chapa solida con manija – caja cuadrada del filtro quedaría como un tipo maletín
- Tenemos 3 laterales perforados:
1- Lateral del costado izquierdo donde estaría la bomba peristáltica + caja con las conexiones eléctricas: driver – esp32 – etc.
2- Lateral fondo donde estaría el pre filtro – filtro – sensores
3- Lateral derecho transformador
4- Puerta de adelante para abrir y cerrar.

La caja de filtro se encastraria al modulo del tanque de permeado con tornillos en los dos brazos de arriba, esto es para que se pueda retirar la misma sin problema en caso de que se tenga que cambiar de lugar o hacer algunos mantenimientos

3) MODULO DEL TANQUE DE PERMEADO
- Base de chapa solida con rueditas para transportarse
- Altura de 70 cm y ancho 40 cm
- Lateral de atrás chapa solida
- Arriba dos brazos para poder encastrar la caja de filtro

El modulo del tanque de permeado se encastraría a la caja de filtro arriba en los dos brazos para poder encastrar la caja de filtro.

El material que se va a utilizar para realizar la estructura seria en principio estructural 2x2 que se pueda soldar, también se debería buscar chapa sólida.
