enzoocorte/Planta-Ultrafiltracion/01_Hito1_Control_Accionamiento_NEMA34_DM860/01_Hardware_y_Cableado/Guia_Ferreteria_e_Hidraulica_Base.md

# 🚰 GUÍA DE FERRETERÍA E HIDRÁULICA BASE PARA LA PLANTA PILOTO

Esta guía detalla las especificaciones de roscas, diámetros de mangueras y accesorios que los tesistas deben conseguir en ferreterías o casas de neumática/hidráulica para acoplar la membrana FX100, la bomba peristáltica y el sedimentador.

---

## 📐 1. Especificaciones de Tuberías y Mangueras

| Tramo Hidráulico | Manguera Recomendada | Diámetro Interior | Razón Técnica |
| :--- | :--- | :---: | :--- |
| **Aspiración Sedimentador ➔ Bomba** | Manguera de Silicona o PVC Cristal | $6\text{ mm}$ u $8\text{ mm}$ | Transparente para verificar visualmente la ausencia de burbujas de aire. |
| **Cabezal Bomba MBP-2000** | Manguera de Silicona / PharMed BPT | $6.4\text{ mm}$ ($1/4"$) | Manguera elástica con memoria mecánica para resistencia a la fatiga peristáltica. |
| **Impulsión Bomba ➔ Filtro FX100** | Silicona trenzada o Poliuretano (PU) | $6\text{ mm}$ | Soporta hasta $2\text{ bar}$ de presión sin hincharse (evita amortiguar los pulsos). |
| **Salida Retentado y Permeado** | Silicona cristal común | $6\text{ mm}$ | Se conecta a las espigas de los caudalímetros YF-S401 ($6.5\text{ mm}$). |

---

## 🔩 2. Accesorios de Derivación para Sensores de Presión (Tees)

Para intercalar los 3 transductores de presión en la línea:
* **Rosca de los Transductores**: Rosca cilíndrica **`G1/4" (BSP)`** macho.
* **Pieza a comprar (x3 unidades)**:
  * Tee plástica o de latón con rosca hembra central `G1/4"` y dos extremos con espiga para manguera de $6\text{ mm}$ u $8\text{ mm}$.
  * O una Tee rosca `1/4" H-H-H` + dos espigas rosca macho `1/4"` a espiga de manguera.
* **Sellador**: Cinta teflón de alta densidad en las roscas macho para evitar microfugas.

---

## 🎛️ 3. Válvulas Manuales de Ajuste
* Se recomienda intercalar una **válvula esférica miniatura de 1/4" o robinete de aguja** en la línea de retentado para regular la contrapresión y la tasa de recuperación de la membrana.

---

## 🎯 Entregable Concreto de esta Guía
* **Circuito hidráulico base ensamblado y estanco**: Mangueras de silicona de $6\text{ mm}$ y $8\text{ mm}$ cortadas a medida, acopladas firmemente al cabezal de la bomba MBP-2000, tees de derivación $G1/4"$ con cinta teflón y sellado verificado a presión sin goteos.

---

## 📋 Lista de Verificación (Checklist de Avance)
- [ ] Manguera de succión instalada desde la salida del sedimentador hasta la entrada de la bomba peristáltica MBP-2000.
- [ ] Tramo de manguera PharMed BPT o silicona de alta resiliencia instalado dentro del rotor peristáltico ($6.4\text{ mm}$ int.).
- [ ] Manguera de impulsión montada desde la salida de la bomba hacia la entrada de la membrana FX100.
- [ ] 3 Tees roscadas $G1/4"$ provistas con espigas para manguera y teflonadas en sus roscas.
- [ ] Válvula miniatura esférica o aguja intercalada en la línea de retentado para regulación de flujo.
- [ ] Prueba estática de estanqueidad con agua corriente verificada (cero fugas de agua o entrada de aire).
