enzoocorte/Planta-Ultrafiltracion/Curso_Congreso_Quimica/GUIA_LABORATORIO_IMPRIMIR_CONEIQ_2026.md

# 📋 XXIX CoNEIQ Salta 2026 — Taller de Tratamiento de Aguas
## GUÍA RÁPIDA DE OPERACIÓN EN MESADA (HOJA PARA IMPRIMIR)
**Docentes:** Dr. Ing. Emilio Almazán & Ing. Enzo Corte (UNSa / INIQUI)  
**Audiencia:** 30 Estudiantes Inscriptos (5 Brigadas de 6 alumnos + 1 Vaso Control Docente)  
**Actividad:** Ensayo de Jarras en Vasos de 1000 mL (1 Litro) — Biocoagulantes (*Opuntia*) vs. Sulfato de Aluminio

---

### 1. 📝 Checklist Previo al Ensayo (100% Agua de Red)

- [ ] **Vasos de Precipitado:** Disponer **6 vasos de 1000 mL (1 Litro)** rotulados del **V1 al V6**.
- [ ] **Carga de Agua:** Cargar exactamente **$1000\text{ mL}$ ($1\text{ L}$)** de agua de red de canilla en cada vaso con probeta.
- [ ] **Pesada y Dispersión de Arcilla:** Pesar arcilla tamizada ($<45\ \mu\text{m}$, malla #325) y dispersar con varilla 30 s:
  - **V1 (Docente):** Agregar **$4.00\text{ g}$** de arcilla en 1 L ($\approx 450\text{ NTU}$ — Control de crecida natural).
  - **V2, V3 y V4 (Brigadas 1, 2 y 3 - Baja Turbidez):** Agregar **$1.00\text{ g}$** de arcilla en 1 L c/u ($\approx 120\text{ NTU}$).
  - **V5 y V6 (Brigadas 4 y 5 - Alta Turbidez):** Agregar **$4.00\text{ g}$** de arcilla en 1 L c/u ($\approx 450\text{ NTU}$).
- [ ] **Solución Stock de Sulfato al 1.0% ($10\text{ mg/mL}$):** Disolver **$2.50\text{ g}$** de Sulfato de Aluminio puro en **$250\text{ mL}$** de agua de red en matraz o vaso.
- [ ] **Biocoagulante de Penca (Hidrogel suave):** Hidratar cubitos 15 min en agua y dar 6 pulsos suaves de 2 s. Pesar en balanza: **$0.50\text{ g}$** (para V3), **$1.80\text{ g}$** (para V4) y **$0.60\text{ g}$** (para V6).
- [ ] **Turbidímetro HANNA:** Encender, calibrar y verificar pañuelos tissue sin pelusa para limpieza de cubetas.

---

### 2. 🧪 Cuadro Maestro de Dosificación (Vasos de 1000 mL)

| Vaso | Asignación | Matriz en Vaso (1 L) | Turb. Est. | Coagulante | Dosis Equivalente | ¿Cuánto agregar al Minuto 0? |
| :---: | :---: | :---: | :---: | :---: | :---: | :---: |
| **V1** | **Docentes (Control)** | $1000\text{ mL} + 4.0\text{ g}$ arcilla | $\approx 450\text{ NTU}$ | **Blanco** | $0\text{ mg/L}$ | **Nada ($0\text{ mL}$)** |
| **V2** | **Brigada 1 (6 alumnos)** | $1000\text{ mL} + 1.0\text{ g}$ arcilla | $\approx 120\text{ NTU}$ | **Sulfato de Aluminio** | $20\text{ mg/L}$ | **$2.0\text{ mL}$** de stock al 1% |
| **V3** | **Brigada 2 (6 alumnos)** | $1000\text{ mL} + 1.0\text{ g}$ arcilla | $\approx 120\text{ NTU}$ | **Penca (*Opuntia*)** | $0.5\text{ g/L}$ | **$0.50\text{ g}$** de hidrogel fresco |
| **V4** | **Brigada 3 (6 alumnos)** | $1000\text{ mL} + 1.0\text{ g}$ arcilla | $\approx 120\text{ NTU}$ | **Penca (SOBREDOSIS)** | $1.8\text{ g/L}$ | **$1.80\text{ g}$** de hidrogel fresco *(Visual!)* |
| **V5** | **Brigada 4 (6 alumnos)** | $1000\text{ mL} + 4.0\text{ g}$ arcilla | $\approx 450\text{ NTU}$ | **Sulfato de Aluminio** | $40\text{ mg/L}$ | **$4.0\text{ mL}$** de stock al 1% |
| **V6** | **Brigada 5 (6 alumnos)** | $1000\text{ mL} + 4.0\text{ g}$ arcilla | $\approx 450\text{ NTU}$ | **Penca (*Opuntia*)** | $0.6\text{ g/L}$ | **$0.60\text{ g}$** de hidrogel fresco |

---

### 3. ⏱️ Cronómetro Operativo de Corrida (16 Minutos Exactos)

```
[00:00 - 01:00]  MEZCLA RÁPIDA: 150 RPM (1 min)  --> Dosificar en simultáneo al arrancar
[01:00 - 06:00]  MEZCLA LENTA:   25 - 30 RPM (5 min) --> Crecimiento de macroflóculos (ortocinética)
[06:00 - 16:00]  SEDIMENTACIÓN:   0 RPM (10 min) --> Decantación estática (Ley de Stokes)
[16:00 en adel.] MEDICIÓN:       Lectura de Turbidez con HANNA a 2 cm de profundidad
```

* **Min 0:00 - 1:00:** Encender las 6 paletas a $150\text{ RPM}$. Las brigadas agregan simultáneamente sus reactivos. Dispersión macromolecular instantánea.
* **Min 1:00 - 6:00:** Bajar a $25 - 30\text{ RPM}$. Los alumnos observan la formación de macroflóculos en V3 y V6 vs. flóculos densos en V2 y V5, y la opacidad lechosa en V4.
* **Min 6:00 - 16:00:** Cortar agitación ($0\text{ RPM}$) y elevar con suavidad las paletas. Reposo total durante 10 minutos.
* **Min 16:00:** Pipetear muestra a **$2\text{ cm}$ por debajo de la superficie** (sin tocar el fondo). Limpiar celda con tissue, alinear muesca y presionar `READ` en el HANNA.

---

### 4. 📊 Planilla de Registro en Mesada (Para Completar a Mano)

$$\text{Remoción de Turbidez (\%)} = \left(\frac{T_i - T_f}{T_i}\right) \times 100 \qquad\qquad \Delta\text{pH} = \text{pH}_f - \text{pH}_i$$

| Vaso | Asignación | Tratamiento | Dosis | Turb. $T_i$ [NTU] | Turb. $T_f$ 10m [NTU] | Remoción [\%] | $\text{pH}_i$ | $\text{pH}_f$ | Aspecto Visual del Flóculo |
| :---: | :--- | :--- | :---: | :---: | :---: | :---: | :---: | :---: | :--- |
| **V1** | Docente | Blanco (Alta Turb.) | $0$ | | | | | | Sin cambio / Limo grueso decanta, turbio |
| **V2** | Brigada 1 | Sulfato de Aluminio | $20\text{ mg/L}$ | | | | | | Flóculos compactos, transparente |
| **V3** | Brigada 2 | Penca Óptima | $0.5\text{ g/L}$ | | | | | | **Macroflóculos, agua cristalina (<3 NTU)** |
| **V4** | Brigada 3 | Penca SOBREDOSIS | $1.8\text{ g/L}$ | | | | | | **Opaca / Turbia (Reestabilización)** |
| **V5** | Brigada 4 | Sulfato de Aluminio | $40\text{ mg/L}$ | | | | | | Manto voluminoso por barrido |
| **V6** | Brigada 5 | Penca Óptima | $0.6\text{ g/L}$ | | | | | | Red polimérica densa, rápida caída |

---

### 5. 💡 Preguntas Disparadoras y Chuleta para el Docente

1. **¿Por qué V4 (sobredosis en baja turbidez) clarificó mucho peor que V3?**  
   *Respuesta técnica:* **Impedimento estérico y saturación coloidal.** El exceso de biopolímero recubre individualmente cada partícula de arcilla. Al no haber sitios activos libres, las partículas se repelen y no forman puentes, manteniéndose en suspensión.
2. **¿Por qué el sulfato baja el pH ($\approx -1.0$) y la penca no ($\approx 0$)?**  
   *Respuesta técnica:* El catión $Al^{3+}$ se hidroliza liberando $H^+$ al medio acuoso, consumiendo alcalinidad. La penca actúa como polielectrolito neutro/débil sin transferir protones.
3. **¿Por qué prehidratamos la penca 15-20 min?**  
   *Respuesta técnica:* Permite el hinchamiento osmótico (*swelling*) del mucílago, relajando las cadenas para extraer el hidrogel íntegro con pulsos suaves sin romperlas covalentemente por alto cizallamiento.
4. **Reserva para el Jueves (Planta de Ultrafiltración):**  
   Sifonar con pipeta o sifón **$600\text{ a }700\text{ mL}$** del sobrenadante de **V2, V3 y V5**, y reservar una alícuota de **Agua Cruda ($400\text{ NTU}$)**. Guardar en botellas rotuladas.
