enzoocorte/Planta-Ultrafiltracion/06_Hito6_Evaluacion_Industrial_Energia_Costos/01_Consumo_Energetico_SEC/Guia_Calculo_SEC_Consumo_Especifico.md

# ⚡ GUÍA SUBHITO 6.1: Cálculo del Consumo Específico de Energía (SEC en kWh/m³)
## Evaluación Energética del Tren de Impulsión Peristáltico, Potencia Eléctrica y Optimización de Proceso

**Proyecto:** Planta Piloto de Ultrafiltración por Flujo Cruzado & Reactor de Coagulación-Sedimentación  
**Tesistas de Grado:** Antonella Guitián & Owen Cañizares  
**Codirector:** Ing. Enzo *(Tesis Doctoral en Procesos de Separación por Membranas)*
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
