enzoocorte/Planta-Ultrafiltracion/00_General_y_P_ID_Planta/02_Diagrama_PID_y_Filosofia_Control/boceto_original_enzo_pid.jpg

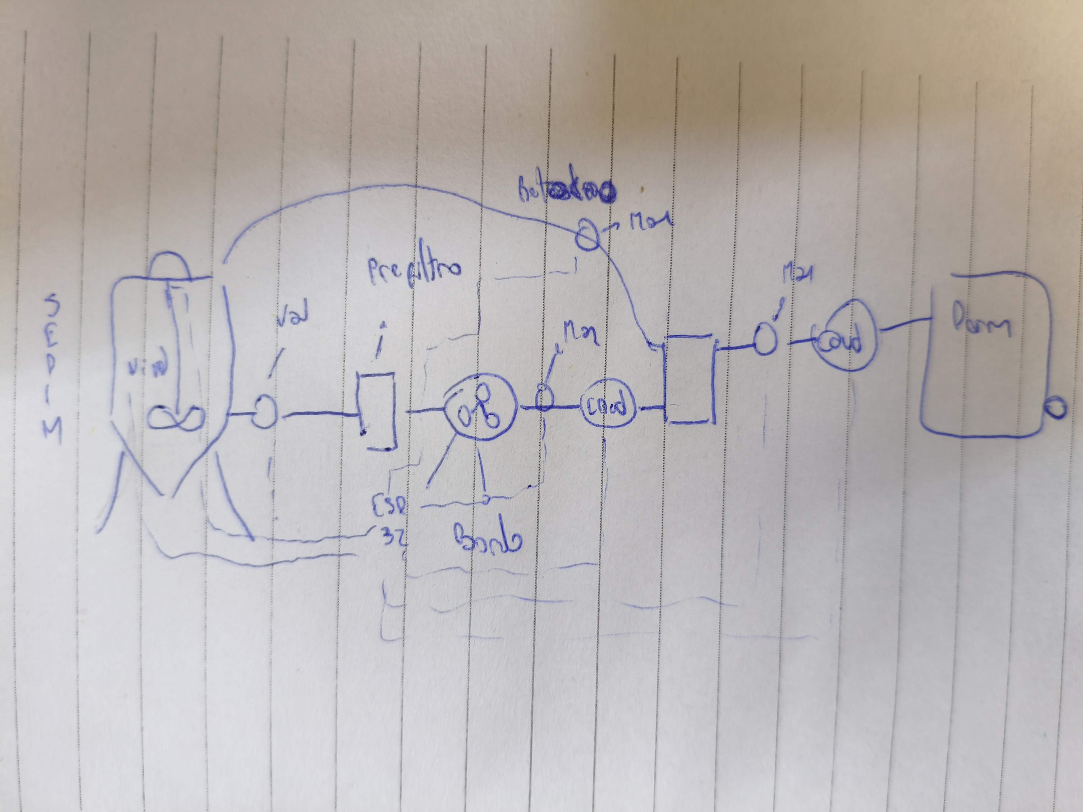
00_General_y_P_ID_Planta/02_Diagrama_PID_y_Filosofia_Control/boceto_original_enzo_pid.jpg
