enzoocorte/Planta-Ultrafiltracion/03_Hito3_Reactor_Sedimentador_Agitador/driver motor 2.jpeg

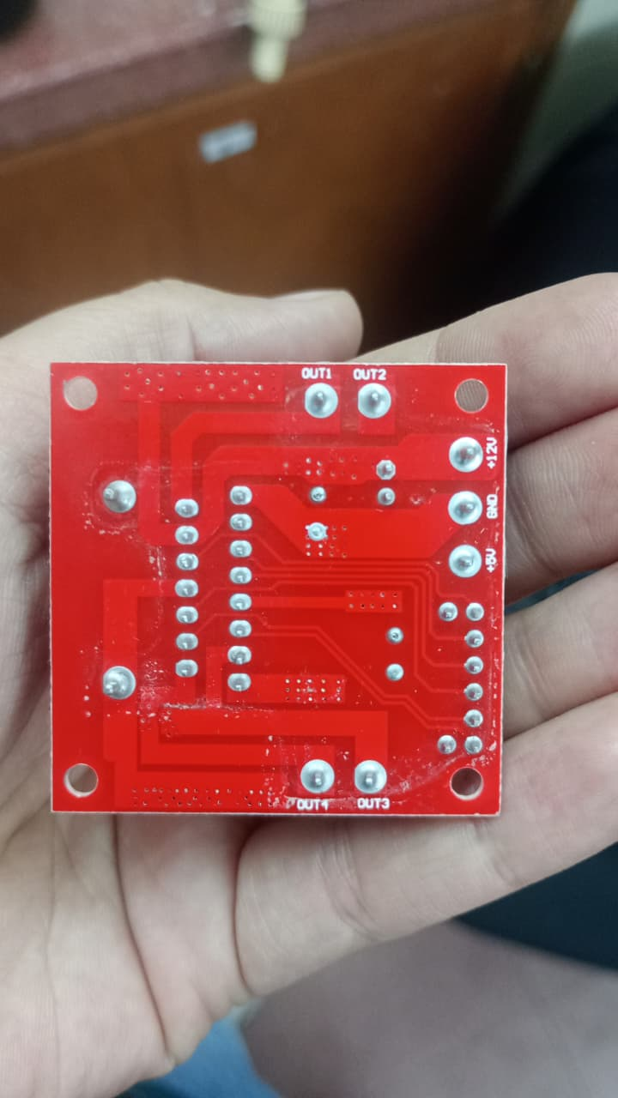
03_Hito3_Reactor_Sedimentador_Agitador/driver motor 2.jpeg
