enzoocorte/Planta-Ultrafiltracion/03_Hito3_Reactor_Sedimentador_Agitador/motor 12 v.jpeg

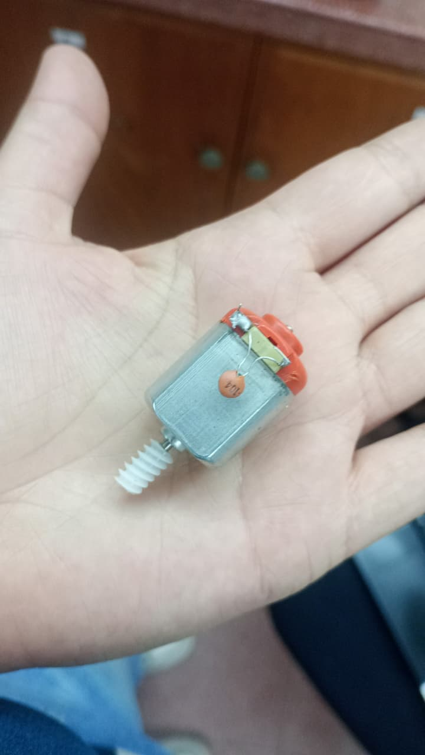
03_Hito3_Reactor_Sedimentador_Agitador/motor 12 v.jpeg
