enzoocorte/Planta-Ultrafiltracion/Curso_Congreso_Quimica/IMG_20261019_135244.jpg

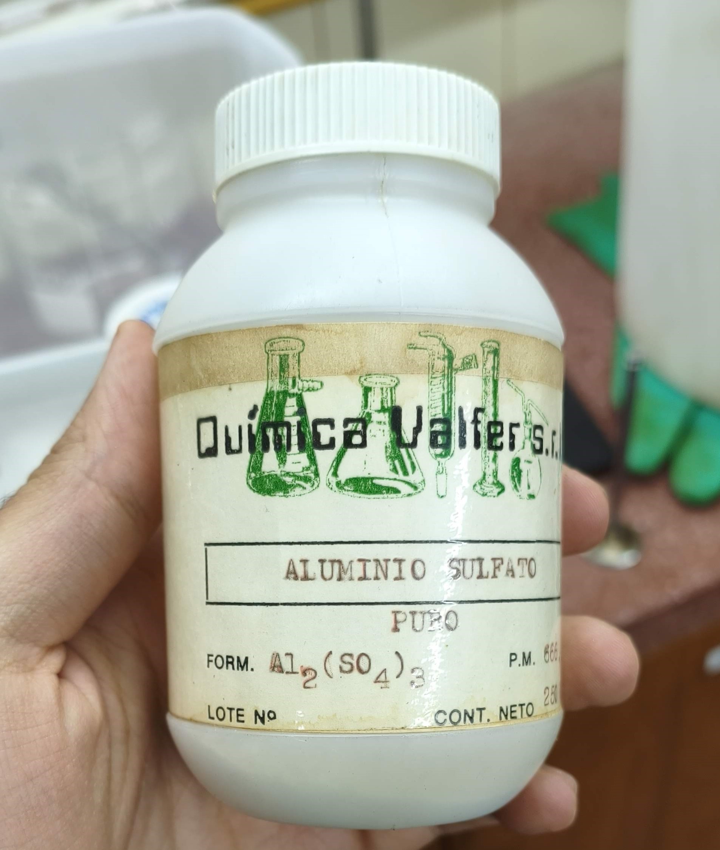
Curso_Congreso_Quimica/IMG_20261019_135244.jpg
