enzoocorte/Planta-Ultrafiltracion/ESTRUCTURA PARA EL FILTRO/3 modulos.jpeg

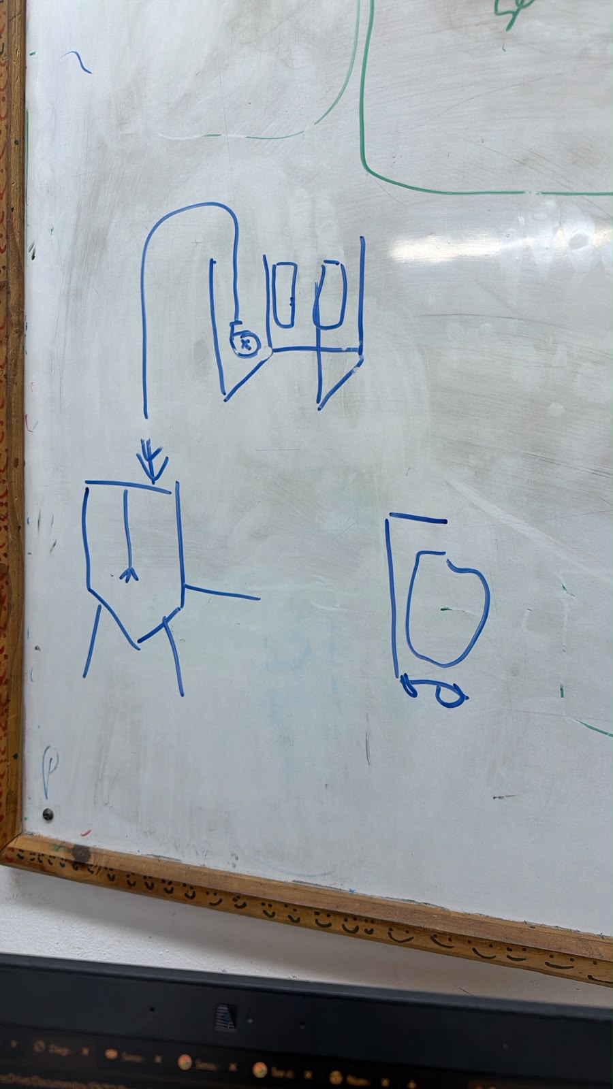
ESTRUCTURA PARA EL FILTRO/3 modulos.jpeg
