enzoocorte/Planta-Ultrafiltracion/ESTRUCTURA PARA EL FILTRO/modulo sedimentador.jpeg

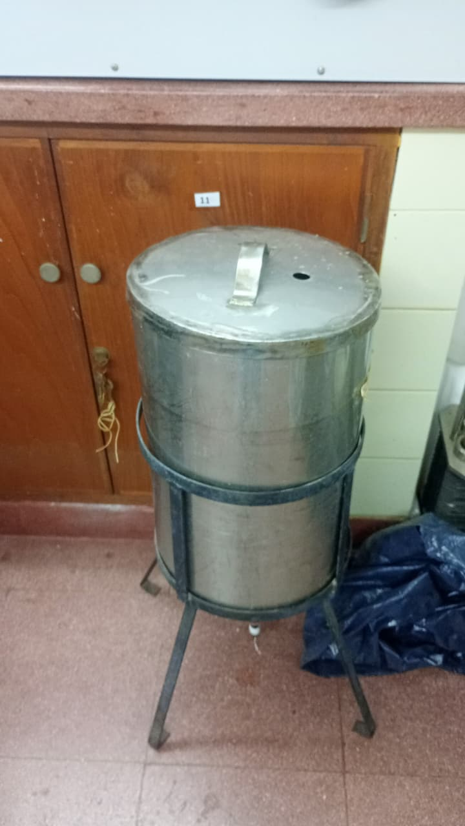
ESTRUCTURA PARA EL FILTRO/modulo sedimentador.jpeg
