enzoocorte/Planta-Ultrafiltracion/IMG_20251128_112640.jpg

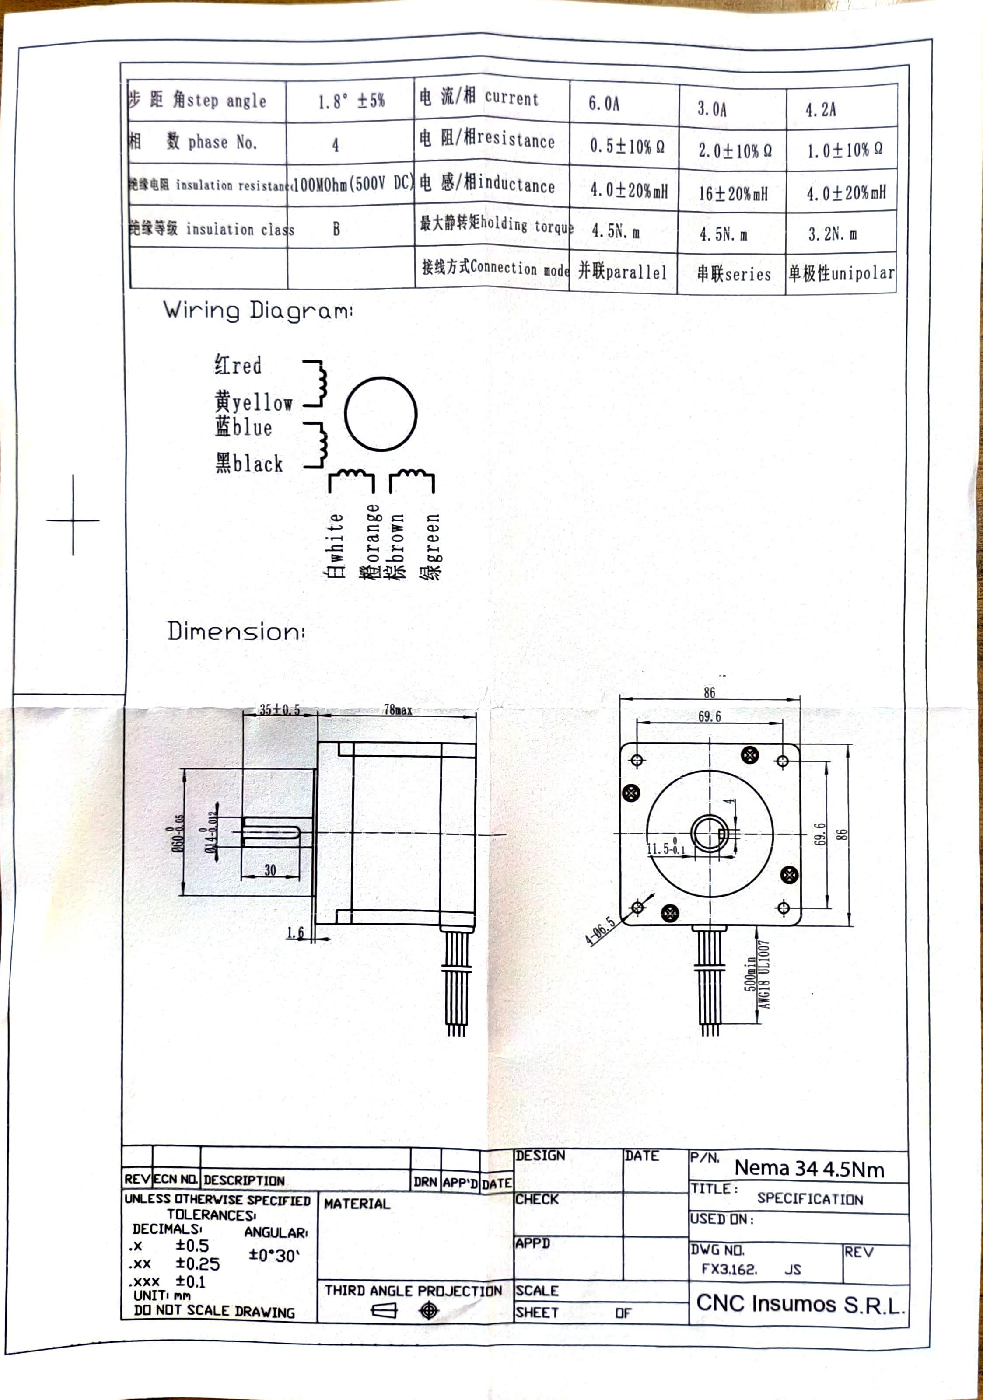
IMG_20251128_112640.jpg
