enzoocorte/Planta-Ultrafiltracion/03_Hito3_Reactor_Sedimentador_Agitador/04_Galeria_y_Montaje_Mecanico/README.md

# 📸 Galería Fotográfica y Guía Visual de Montaje Mecánico del Sedimentador
## Planta Piloto de Ultrafiltración — Hito 3 (UNSa 2026)

**Ubicación:** `03_Hito3_Reactor_Sedimentador_Agitador/04_Galeria_y_Montaje_Mecanico/`  
**Objetivo:** Documentar gráficamente los componentes físicos del sedimentador cónico, motorreductor de 12V, acople por tornillo sinfín, driver Puente H L298N y conexionado con el ESP32.

---

## 📂 Archivos en esta Galería

| Archivo | Tipo | Descripción |
| :--- | :--- | :--- |
| **[`guia_conexion_sedimentador.html`](./guia_conexion_sedimentador.html)** | Guía Web Interactiva | Manual visual interactivo paso a paso con esquemas de conexionado de pines, pinout L298N, ajuste de PWM y fotos ampliables. |
| **`motor 12 v.jpeg`** | Fotografía | Motorreductor DC de $12\text{V}$ con tornillo sinfín (*worm gear*) para alto torque y reducción mecánica a bajas RPM ($20\text{--}150\text{ RPM}$). |
| **`motor 12 v a.jpeg`** / **`motor 12 v b.jpeg`** | Fotografía | Vistas laterales y de la tapa del motorreductor. |
| **`MOTOR.jpeg`** / **`MOTOR 2.jpeg`** | Fotografía | Detalles del rotor y montaje del soporte superior del motor. |
| **`driver motor.jpeg`** / **`driver motor 2.jpeg`** | Fotografía | Módulo driver Puente H L298N (HW-095) con borneras de potencia y disipador de aluminio. |
| **`PALETA.jpeg`** | Fotografía | Paleta de agitación diseñada para generar gradientes de Camp-Stein controlados sin romper flóculos. |
| **`SEDIMENTADOR.jpeg`** | Fotografía | Vista general del tanque reactor cónico de acero inoxidable. |
| **`SEDIMENTADOR BASE.jpeg`** | Fotografía | Base estructural trípode metálica con apoyos regulables de nivelación. |
| **`TAPA SEDIMENTADOR.jpeg`** | Fotografía | Tapa superior con orificio excéntrico para el paso del eje y sujeción de la boya de nivel de acero inoxidable. |

---

> [!NOTE]
> Para ver el manual interactivo con diagramas y visualizador fotográfico completo, abrir [`guia_conexion_sedimentador.html`](file:///c:/Users/enzoo/OneDrive/Documentos/ENZO/Domotica/SistemaUF/03_Hito3_Reactor_Sedimentador_Agitador/04_Galeria_y_Montaje_Mecanico/guia_conexion_sedimentador.html) en cualquier navegador web.
