enzoocorte/Planta-Ultrafiltracion/02_Hito2_Instrumentacion_Sensores/Guia_Montaje_Hidraulico_Sensores.md

# 🚰 GUÍA DE MONTAJE HIDRÁULICO DE SENSORES

Esta guía detalla la ubicación física recomendada para cada sensor en el circuito hidráulico de la planta de ultrafiltración.

---

## 🗺️ 1. Diagrama de Ubicación de Instrumentación

```
                        ESQUEMA DE UBICACIÓN FÍSICA DE SENSORES
                        =======================================

   [ SEDIMENTADOR ]
         │
         ├──► [ Sonda TDS 1 (Agua Cruda / Alimentación) ]
         │
         ▼
   [ BOMBA PERISTÁLTICA MBP-2000 ]
         │
         ▼
   [ MÓDULO ULTRAFILTRACIÓN FRESENIUS FX100 ]
         │
         ├──────────────────────────────────────────┐
         │ (Línea de Permeado - Agua Filtrada)      │ (Línea de Retentado / Concentrado)
         ▼                                          ▼
   [ Caudalímetro YF-S401 (Permeado Qp) ]     [ Caudalímetro YF-S401 (Retentado Qc) ]
         │                                          │
         ├─► [ Sonda DS18B20 (Temp Permeado) ]      ▼
         ├─► [ Sonda TDS 2 (Calidad Permeado) ]   [ Válvula Reguladora de Retentado ]
         ▼                                          │
   [ TANQUE DE RECOLECCIÓN PERMEADO ]               ▼
                                              [ RECIRCULACIÓN O DESCARTE ]
```

---

## 🔧 2. Consejos Prácticos de Instalación

1. **Sentido de Flujo en Caudalímetros YF-S401**:
   * En el cuerpo plástico de cada caudalímetro hay una **flecha grabada** que indica la dirección del agua. Instalar siempre con la flecha apuntando en el sentido del flujo.
   * Mantener el caudalímetro en posición horizontal para evitar burbujas atrapadas en la cámara de la turbina.
2. **Inmersión de las Sondas (DS18B20 y TDS)**:
   * La sonda de acero inoxidable del DS18B20 y los electrodos de la sonda TDS deben quedar permanentemente sumergidos en la corriente líquida sin tocar las paredes metálicas de los recipientes para evitar lecturas falsas de conductividad.
