enzoocorte/Planta-Ultrafiltracion/00_General_y_P_ID_Planta/01_Estructura_y_Montaje_Filtro/explicacion estructura.jpeg

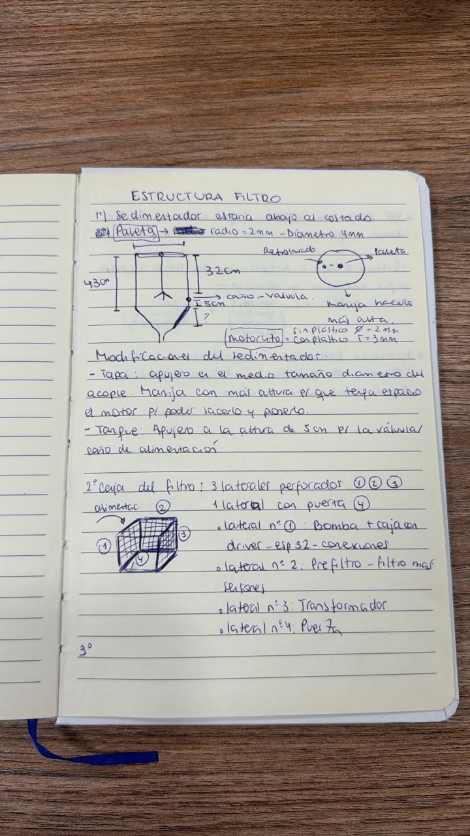
00_General_y_P_ID_Planta/01_Estructura_y_Montaje_Filtro/explicacion estructura.jpeg
