enzoocorte/Planta-Ultrafiltracion/01_Hito1_Control_Accionamiento_NEMA34_DM860/02_Montaje_y_Optimizacion_Motor/IMG_20251128_112538.jpg

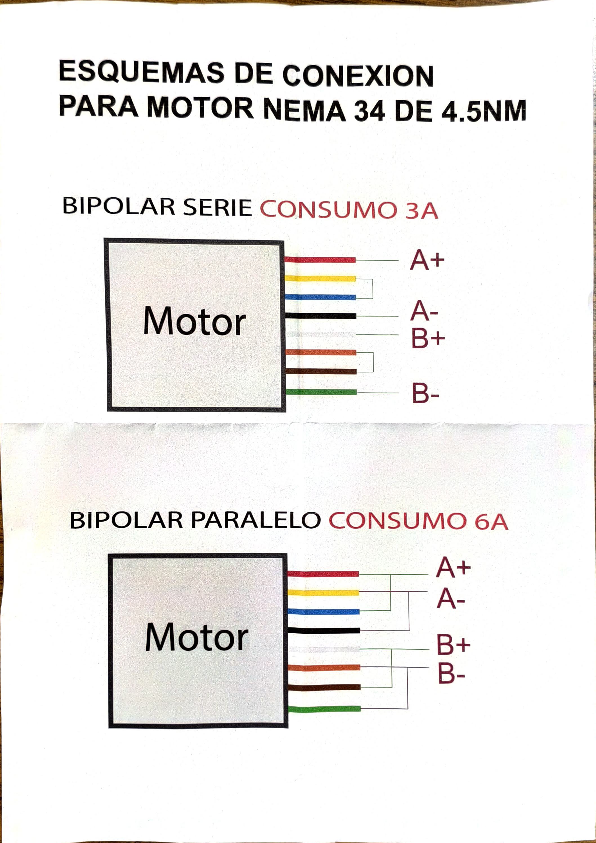
01_Hito1_Control_Accionamiento_NEMA34_DM860/02_Montaje_y_Optimizacion_Motor/IMG_20251128_112538.jpg
