enzoocorte/Planta-Ultrafiltracion/03_Hito3_Reactor_Sedimentador_Agitador/04_Galeria_y_Montaje_Mecanico/MOTOR 2.jpeg

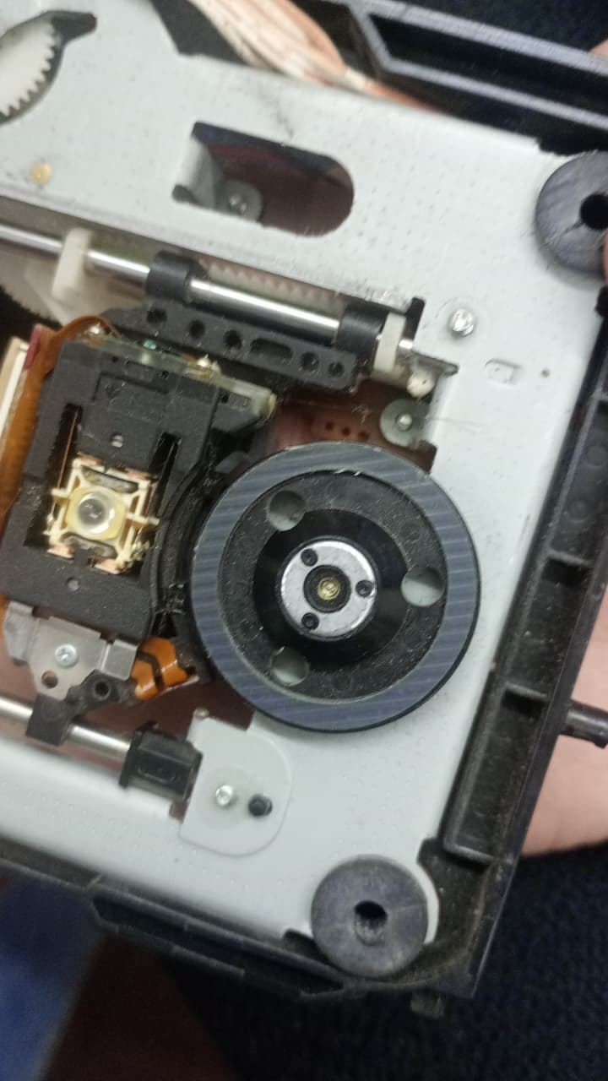
03_Hito3_Reactor_Sedimentador_Agitador/04_Galeria_y_Montaje_Mecanico/MOTOR 2.jpeg
