enzoocorte/Planta-Ultrafiltracion/02_Hito2_Instrumentacion_Sensores/01_Guias_Montaje_y_Calibracion/Esquemas_Conexionado_HTML/conexion_caudalimetro_shield_capacitor.html

Sensor 1: 5V (Con R 4.7 kΩ Protección) Sensor 2: 3.3V (Directo sin Resistencia) 2 Terminal Adapters Apilados en Vertical

# Montaje Vertical: Sensor 1 (5V con R 4.7k) y Sensor 2 (3.3V Directo)

Exactamente por eso se necesita la resistencia: el Sensor 1 alimentado a 5V requiere la R de 4.7 kΩ para proteger el pin P27 del ESP32, mientras que el Sensor 2 alimentado a 3.3V entra directo a P14 sin resistencia.

Ver circuito: 🌐 Todo el Ruteo 🔴 Sensor 1: Rama 5V con R 4.7k (P27) 🔵 Sensor 2: Rama 3.3V Directo (P14) ⚡ Alimentaciones (5V y 3V3) 🛡️ Capacitores 104 (Ambos a Masa)

## Plano de Montaje Vertical Dual: Línea 5V y Línea 3.3V

Ruteo vertical pin a pin entre ambas placas Terminal Adapter

⚡ Por qué uno lleva Resistencia y el otro No

Parámetro | Caudalímetro 1 (Permeado Qp) | Caudalímetro 2 (Retentado Qc)
Alimentación (VCC) | 🔴 5V (del borne 5V del ESP32) | 🔵 3.3V (del borne 3V3 del ESP32)
Tensión de los Pulsos | Pulsos de 0V a 5V | Pulsos de 0V a 3.3V (Nativo)
¿Necesita Resistencia? | 🟣 SÍ, R = 4.7 kΩ obligatoria: Limita la corriente y protege el pin P27 contra la sobretensión de 5V. | 🟢 NO, directo a P14: Al estar alimentado a 3.3V, la señal ya es 100% segura para el ESP32.
Capacitor 104 (100nF) | 🟠 Conectado entre la señal filtrada y GND. | 🟠 Conectado en puente entre la señal directa y GND.

🛡️ Seguridad Eléctrica para el ESP32

¡Tu diseño tiene total coherencia de ingeniería!:
• Los pines GPIO del ESP32 soportan un máximo de 3.6V.
• Al alimentar el Sensor 1 a 5V, la resistencia en serie de 4.7 kΩ absorbe la diferencia de potencial ($5\text{V} - 3.3\text{V} = 1.7\text{V}$) y limita la corriente a apenas $0.36\text{ mA}$, permitiendo que los diodos clamping internos del ESP32 recorten la señal sin calentarse ni quemarse.
• Al alimentar el Sensor 2 a 3.3V, no hay ningún riesgo de sobretensión, por lo que el cable viaja directo sin necesidad de resistencia.
