enzoocorte/Planta-Ultrafiltracion/02_Hito2_Instrumentacion_Sensores/01_Guias_Montaje_y_Calibracion/Esquemas_Conexionado_HTML/conexion_nodo_pullup_3v3_caudalimetros.html

Riel Común 5V (5V/VIN) Riel Común GND (Masa Estrella) Riel Común 3.3V (Pull-Up Ref) Señal Permeado P27 (Aislada) Señal Alimentación P14 (Aislada)

# Topología de Conexión: Placa 1 Arriba (Campo) y Placa 2 Abajo (ESP32)

Tamaño compacto y enlace vertical 100% directo: Placa 1 Superior (Acondicionamiento y Filtros) y Placa 2 Inferior (CPU ESP32 NodeMCU-32S), unidas por 5 conductores verticales rectos sin cruces ni cables pasando por encima.

Aislar circuito: 🌐 Ver Sistema Completo 🔴 Riel Común 5V (Sensores + Buffer) ⚫ Riel Común GND (Masa Estrella) 💧 Riel Común 3.3V (Pull-up) 🟡 Señal P27 Aislada (Permeado) 🔵 Señal P14 Aislada (Alimentación)

## Plano Vertical Despejado (Bornera 2 Movida Abajo con Enlace Directo)

Toca los botones superiores para aislar cada trazo sin interferencias
