enzoocorte/Planta-Ultrafiltracion/02_Hito2_Instrumentacion_Sensores/01_Guias_Montaje_y_Calibracion/Esquemas_Conexionado_HTML/esquema_conexion_borneras.html

Tesis de Grado • Planta Piloto FX100 • Salta, Argentina

# Arquitectura Doble Bornera Shield ZS-1057

Módulo Placa 2 (Front-End & Filtrado) recepciona sensores y componentes pasivos; la Placa 1 (ESP32 Master) recibe solo señales limpias.

Filtrar Circuito: 🔍 Ver Todo 🌊 Caudalímetro Feed (P14) 💧 Caudalímetro Permeado (P27) 🌡️ Sensor Temp DS18B20 (P4) 🛑 Boya Nivel Inox (P32) 📊 Conversor ADS1115 (I2C) ⚡ Puentes de Poder (5V/3.3V/GND) ⚖️ ¿Por qué 5V + 4.7kΩ y no 3.3V directo? (Explicación para Owen)

PLACA 2: FILTRADO & SENSORES Haz clic en cualquier borne o cable para inspeccionarlo PLACA 1: ESP32 MASTER CPU

🔍

## Inspector de Borne

SELECCIONA UN BORNE -- V

### Borne P14 (Placa 2)

Haz clic sobre cualquier terminal [5V], [GND], [P14], [P27], etc. en el gráfico para ver exactamente qué cables, resistencias y capacitores van atornillados en ese agujero.

#### Elementos en este Borne:

- Ningún borne seleccionado

#### ⚡ Resumen de Operación Mañana

1. Unir 5V, GND y 3.3V de Placa 1 a Placa 2.
2. Atornillar R de 4.7kΩ entre 3.3V y P14/P27.
3. Atornillar C de 100nF entre GND y P14/P27.
4. Conectar cables amarillos de sensores a P14 y P27.
5. Tirar cables limpios de Placa 2 a Placa 1.

🔬

### Análisis Físico y Matemático: ¿Por qué 5V + 4.7kΩ y no 3.3V directo?

Explicación técnica detallada para Owen y Antonella

×

1. Conexión de Owen (3.3V + Pull-Up Interno) FALLA CON MOTOR

- ❌ Pull-Up Débil: El ESP32 tiene internamente una resistencia de $\approx 45\text{ k}\Omega$.
- ❌ Línea de alta impedancia: Funciona como antena y capta los chispazos de $3.0\text{A}$ del NEMA 34.
- ❌ Resultado: Cada paso del motor induce $V = 50\mu\text{A} \times 45\text{k}\Omega = \mathbf{2.25\text{V}}$. El micro cuenta cientos de litros falsos.

2. Conexión Industrial (5V + 4.7kΩ + 100nF) 100% INMUNE

- ✅ Pull-Up Fuerte: La resistencia de $4.7\text{ k}\Omega$ reduce $10\times$ la impedancia de la línea.
- ✅ Filtro Pasabajos RC: El capacitor de $100\text{ nF}$ manda a tierra toda frecuencia mayor a $1.6\text{ kHz}$.
- ✅ Resultado: El ruido inducido es de apenas $V = 50\mu\text{A} \times 4.7\text{k}\Omega = \mathbf{0.23\text{V}}$ (inofensivo para el ESP32). Cero falsos conteos.

#### 💡 ¿Por qué alimentar el sensor a 5V NO quema el pin del ESP32?

El sensor YF-S401 tiene salida a transistor colector abierto (*open-collector*). Esto significa que el cable amarillo NUNCA emite voltaje; solo actúa como un interruptor que se conecta a masa ($0\text{V}$) cuando pasa el imán o queda en el aire cuando no pasa.

Como la resistencia de $4.7\text{ k}\Omega$ está conectada al riel de +3.3V, el voltaje en reposo del cable amarillo es de exactamente 3.3V. El ESP32 jamás recibe los 5V de alimentación del sensor.

Dato de Laboratorio: En su código subhito2_1_caudalimetros.ino ya tenían programado el modo de Owen con INPUT_PULLUP, y fue justamente por eso que el motor les metía lecturas fantasma.

Entendido, Volver al Esquema
