enzoocorte/Planta-Ultrafiltracion/02_Hito2_Instrumentacion_Sensores/02_Firmware_Test_Sensores/subhito2_2_v6/PLANILLA_CALIBRACION_ENSAYOS_2_Y_3_COMPLETA.xlsx

Sheet: Ensayo 2 - Bomba (mL-rev)
PLANTA PILOTO DE ULTRAFILTRACIÓN FX100 — UNIVERSIDAD NACIONAL DE SALTA
ENSAYO 2: CALIBRACIÓN CINEMÁTICA Y VOLUMÉTRICA DE LA BOMBA PERISTÁLTICA MBP-2000
Determinación Experimental del Desplazamiento por Revolución (Cilindrada en mL/rev) mediante Probeta de 1000 mL
Instrumento: | Probeta Graduada de 1000 mL |  |  | Manguera: | Silicona Flexible APM (Øint 12 mm, Øext 18 mm)
Fluido de Ensayo: | Agua Desionizada / Limpia a 20 °C |  |  | Cabezal: | MBP-2000 (Rotor 3 rodillos a 120°)
Driver Motor: | Leadshine DM860 (3200 pulsos/rev - 1/16 micropasos) |  |  | Motor: | Paso a Paso NEMA 34 (4.0 N·m)
Operadores: | Owen Cañizares / Antonella Guitián / Enzo |  |  | Ubicación: | Laboratorio de Operaciones Unitarias - UNSa
NOTA OPERATIVA: Ingrese los datos en las celdas amarillas (D y E). Para RPM <= 70 use tiempo de 1.0 min (entra en probeta 1000 mL). Para RPM >= 80 use 0.5 min para evitar desborde.
Corrida # | Consigna Bomba [RPM] | Tiempo Ensayo [min] | Volumen en Probeta [mL] | Caudal Medido Q [mL/min] | Caudal Medido Q [L/min] | Cilindrada [mL/rev] | Caudal Nominal Previo [mL/min] | Desviación vs 13.60 mL/rev [%] | Estado / Linealidad
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
