enzoocorte/Planta-Ultrafiltracion/02_Hito2_Instrumentacion_Sensores/02_Firmware_Test_Sensores/Datos calibración bomba desde 60 rpm.docx

sep=;

PLANTA DE ULTRAFILTRACION FX100 - REGISTRO DE ENSAYOS Y CALIBRACION

Ensayo_ID;Tiempo_s;Tiempo_MinSec;RPM_Bomba;Q_Bomba_Teorico_mLmin;Frec_Alimentacion_Hz;Q_Alimentacion_mLmin;Vol_Alimentacion_L;Frec_PERMEADO_Hz;Q_PERMEADO_mLmin;Vol_PERMEADO_L;Q_Retentado_mLmin;Recuperacion_Y_Pct;Desviacion_Bomba_Alim_Pct;K_Alim;K_Perm;J_LMH

1;1109;18:29;60.0;816.0;154.99;814.7;11.5699;7.96;12.0;0.8778;802.8;1.47;-0.16;196.37;687.33;0.33

1;1110;18:30;60.0;816.0;160.85;816.5;11.5836;1.26;7.9;0.8779;808.6;0.97;0.06;196.37;687.33;0.22

1;1111;18:31;60.0;816.0;147.80;790.9;11.5961;2.21;6.0;0.8779;784.9;0.76;-3.07;196.37;687.33;0.16

1;1112;18:32;60.0;816.0;137.51;754.7;11.6092;2.68;5.2;0.8780;749.5;0.69;-7.52;196.37;687.33;0.14

1;1113;18:33;60.0;816.0;156.30;771.2;11.6224;0.76;3.5;0.8780;767.6;0.46;-5.49;196.37;687.33;0.10

1;1114;18:34;60.0;816.0;152.95;774.2;11.6354;9.39;7.6;0.8783;766.7;0.98;-5.12;196.37;687.33;0.21

1;1115;18:35;60.0;816.0;158.58;787.6;11.6496;26.56;20.0;0.8789;767.6;2.54;-3.48;196.37;687.33;0.55

1;1116;18:36;60.0;816.0;169.12;817.0;11.6639;29.11;28.9;0.8798;788.1;3.54;0.13;196.37;687.33;0.79

1;1117;18:37;60.0;816.0;121.67;738.1;11.6788;50.13;46.5;0.8810;691.5;6.31;-9.55;196.37;687.33;1.27

1;1118;18:38;60.0;816.0;171.10;791.4;11.6933;49.91;57.0;0.8822;734.4;7.20;-3.02;196.37;687.33;1.55

1;1119;18:39;60.0;816.0;169.74;820.6;11.7077;34.58;54.3;0.8830;766.3;6.62;0.56;196.37;687.33;1.48

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

1;1719;28:39;90.0;1224.0;206.81;998.2;21.6908;45.94;64.3;1.3903;934.0;6.44;-18.44;196.37;687.33;1.75

1;1720;28:40;90.0;1224.0;188.29;982.5;21.7091;29.13;55.5;1.3914;927.0;5.65;-19.73;196.37;687.33;1.51
