enzoocorte/Planta-Ultrafiltracion/Capitulo_4_Programacion_Firmware/01_Firmware_ESP32_Produccion/firmware_planta/CALIBRACION_CAUDALIMETROS_PROBETA_50RPM_72RPM.xlsx

Sheet: Resumen Calibración
PLANTA PILOTO DE ULTRAFILTRACIÓN FX100 — UNIVERSIDAD NACIONAL DE SALTA
INFORME DE CALIBRACIÓN HIDRÁULICA Y AJUSTE DE SENSORES YF-S401 (ENSAYO EN PROBETA)
1. PARÁMETROS CINEMÁTICOS Y CALIBRACIÓN DE LA BOMBA PERISTÁLTICA
Parámetro | Valor Consignado / Medido | Unidad | Detalle Técnico / Observación
Velocidad Nominal de Ensayo | 50 | RPM | Punto nominal de calibración con probeta
Caudal Real en Probeta (Alimentación) | 680 | mL/min | Medido volumétricamente con cronómetro
Cilindrada Real Calibrada | 13.6 | mL/rev | q_bomba = 680.0 mL/min / 50.0 RPM
Configuración Driver DM860 | 3200 | pulsos/rev | 1/16 micropasos (Cátodo Común, 50% corriente)
Frecuencia de Pasos a 50 RPM | 2666.67 | Hz | f_step = (50 * 3200) / 60
Rampa de Aceleración | 8 | RPM/s | Arranque suave sin stall (0 a 50 RPM en 6.25 s)
Rampa de Desaceleración | 12 | RPM/s | Frenado controlado (50 a 0 RPM en 4.17 s)
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
