enzoocorte/Planta-Ultrafiltracion/02_Hito2_Instrumentacion_Sensores/02_Firmware_Test_Sensores/subhito2_2_v5/AuditoriaIA/RESPUESTA_ASTRA_RONDA11_DICTAMEN.md

l ensayo y la falta de comprobación de la interfaz eléctrica del DM860.

A continuación separo el dictamen, los hallazgos y una **variante reducida de banco** que permite probar adquisición y calibración sin arrastrar las funciones problemáticas del SCADA. El código propuesto está revisado por inspección; **no lo he compilado ni ejecutado en un ESP32**, por lo que no lo presentaré como firmware certificado o experimentalmente aprobado.

## 1. Respuestas a las cuatro preguntas del expediente

| Pregunta | Dictamen | Fundamento |
|---|---|---|
| Concurrencia | Aceptable con condiciones | Los contadores compartidos están protegidos. No toda la clase es segura para llamadas concurrentes desde múltiples tareas. |
| SCADA y REST | No aprobado | Hay mensajes falsos de éxito, escrituras no comprobadas y rutas que eluden los bloqueos. |
| Sesiones y trazabilidad | Parcialmente correcto | La reserva de FIN funciona, pero se cierra durante el frenado y existen dos sistemas de sesiones incompatibles. |
| Compilación y campaña | Separar etapas | Compilar y probar sin accionamiento: sí. Campaña con V5.2 sin cambios: no. |

Esta es una **revisión técnica**, no una autorización institucional ni una certificación de seguridad. La habilitación física del banco corresponde al responsable del laboratorio.

## 2. Revisión de los diez hallazgos declarados como resueltos

La matriz del expediente no puede darse por cerrada íntegramente.

| Hallazgo original | Estado observado | Observación |
|---|---|---|
| 1. `lbl_kp` inexistente | Corregido | El elemento está en el HTML. |
| 2. Lectura de 64 bits en tara | Corregido localmente | La copia de `_pulsosMedicion` ahora está protegida. |
| 3. Calibración documentada pisada en `setup()` | Corregido | Ya no se vuelve a declarar documentada después de cargar K. |
| 4. Cambio de K y época | Incompleto | Cambia época, pero reinterpreta volumen anterior; otras rutas siguen cambiando K en marcha. |
| 5. Validación previa de endpoints | Incompleto | `/set_dev` mejora; `/calibrar_rpm_q` no valida todos los resultados antes de modificar. |
| 6. Framing del CSV metrológico | Corregido en estructura | El adaptador usa `sendContent`, pero no informa fallos reales de transmisión. |
| 7. Exportación con sesión activa | Corregido localmente | Existe HTTP 409, pero sesión inactiva no significa motor parado. |
| 8. Errores LEDC | Incompleto | No se actualiza `_fActual` si falla frecuencia, pero se sigue intentando aplicar duty y no se declara fallo. |
| 9. RPM en eventos | Parcial | Registra el estado de la rampa, no la velocidad medida del eje. FIN sigue adelantado. |
| 10. Bajo flujo sin nuevos períodos | Correcto con matiz | La muestra contiene `NaN`; el indicador se vuelve cero. No son equivalentes metrológicos. |

## 3. Hallazgos que impiden aprobar la V5.2 completa

### 3.1. El bloqueo de reconfiguración tiene vías de escape

**Se puede modificar K y escribir NVS durante un ensayo activo.**

Ocurre por dos caminos:

- **`handleResetDev()`** no comprueba `registroEnsayos.activo()`.
- **La finalización de auto-calibración** llama a `setK()` y `guardarParametrosNVS()` mientras la bomba sigue en marcha.
- **El estado de sesión puede no existir**, porque se ignora el retorno de `registroEnsayos.iniciar()`.

El tercer punto importa especialmente: cuando se agotan las 20 sesiones, falla la reserva o no se inicializa un sensor, la bomba puede funcionar sin sesión metrológica. Los bloqueos basados exclusivamente en `activo()` dejan entonces de proteger el funcionamiento.

**Corrección necesaria:** prohibir la reconfiguración si hay sesión, movimiento, arranque pendiente, frenado o inversión; comprobar siempre el inicio del registro. Para la primera campaña recomiendo directamente desactivar auto-calibración, reset de fábrica y cambios en caliente.

### 3.2. `setK()` todavía cambia retrospectivamente el volumen

Actualmente se calcula:

```cpp
m.volumenEstimado_L = (double)pulsosNetos / (60.0 * m.k);
```

Pero `setK()` no cierra el totalizador ni modifica su referencia. Por tanto, todos los pulsos anteriores a la nueva K se convierten usando la K nueva.

**Ejemplo calculado:** con 11 790 pulsos y K = 196,5, se obtiene 1 L. Si después K pasa a 200, el mismo acumulado se muestra como 0,9825 L, aunque no haya circulado agua adicional.

Incrementar `_epoca` protege el cálculo entre muestras de épocas distintas, pero **no corrige esa reinterpretación**.

Hay dos soluciones válidas, que deben documentarse:

- **Volumen por época:** al cambiar K, iniciar un volumen nuevo desde cero.
- **Volumen histórico:** cerrar el tramo anterior con su K y sumar después los incrementos del nuevo tramo.

Para la campaña inicial conviene la primera, por simplicidad.

### 3.3. `/calibrar_rpm_q` no implementa una calibración sincronizada

El endpoint utiliza el caudal introducido por el operador y la **última frecuencia disponible**, no la frecuencia del intervalo durante el cual se recogió el volumen.

Además:

- **Rechaza la calibración con sesión activa**, que es precisamente cuando hay flujo y frecuencia actualizada.
- **Después de parar**, la frecuencia puede ser residual o cero.
- **Puede modificar únicamente la cilindrada** y responder éxito aunque no haya actualizado ninguna K.
- **No rechaza `qp` negativo**.
- **No valida previamente los límites de las K calculadas** con la misma política de `/set_dev`.
- **No comprueba los retornos** de `setK()` ni de persistencia.

No se resuelve añadiendo solamente más límites numéricos.

La calibración por volumen debe utilizar el incremento de pulsos **del mismo intervalo de recogida**:

$$
K=\frac{\Delta N}{60\,V_{\mathrm{ref,L}}}
$$

O, si el volumen se introduce en mililitros:

$$
K=\frac{1000\,\Delta N}{60\,V_{\mathrm{ref,mL}}}
$$

El tiempo permite calcular el caudal de referencia:

$$
Q_{\mathrm{ref,mL/min}}=
\frac{60\,V_{\mathrm{ref,mL}}}{\Delta t_{\mathrm{s}}}
$$

**Para obtener K por volumen, no hace falta suponer un caudal constante ni usar las RPM como patrón.** Sí hace falta sincronizar los límites de recogida y conteo.

### 3.4. La auto-calibración no es una referencia independiente

La rutina ajusta K usando:

```cpp
float qRefAlim = bomba.rpmActual() * bomba.getMlPorVuelta();
```

Eso es un **ajuste contra el modelo de la bomba**, no una calibración independiente por probeta o balanza.

Puede ser una comprobación útil después de caracterizar la bomba, pero no debe confundirse con establecer la exactitud del caudalímetro.

Además, las 15 muestras:

- No son necesariamente **15 segundos consecutivos**.
- Pueden pertenecer a **distintas consignas**, porque las sumas no se reinician al perder estabilidad.
- Pueden incorporar frecuencias nulas por falta de período disponible.
- Se contrastan con el caudal teórico **del último instante**.

La interfaz también dice que calibra ambos sensores, aunque el código deja K de permeado intacta.

**Para la primera campaña: desactivar esta función.**

### 3.5. FIN se registra antes de que termine el movimiento

`detener()` cambia inmediatamente `_enMarcha` a `false`. Después, el primer `tick()` detecta el flanco de bajada y finaliza la sesión, aunque la rampa todavía esté frenando.

A 100 RPM, con una actualización de aproximadamente 50 ms, el primer descenso nominal sería:

$$
100-70\cdot0{,}05=96{,}5\ \text{RPM}
$$

Es decir, **FIN puede quedar registrado con casi toda la velocidad inicial**.

Además se pasa `bombaEmpuja=false`, aunque todavía se están emitiendo pulsos. Eso puede activar `SIN_IMPULSION` incorrectamente.

Hay que distinguir:

- **Fin del intervalo de recogida:** decisión metrológica.
- **Orden STOP:** decisión de control.
- **Fin de emisión STEP:** condición eléctrica.
- **Fin del flujo residual:** condición hidráulica.

No tienen por qué coincidir. El firmware debe registrar cuál de ellos define FIN.

### 3.6. Las RPM no son una medida del eje

`rpmActual()` devuelve `_actual`, una variable de la rampa.

No existe encoder ni tacómetro. Por tanto, no se detectan pérdida de pasos, atasco, desacoplamiento ni error de microstepping.

Incluso como velocidad comandada hay discrepancias:

- Se redondea la frecuencia a entero.
- Se impone un mínimo de 50 Hz.
- La actualización de LEDC puede fallar.
- El número configurado de pulsos por vuelta puede no coincidir con los DIP físicos.

**Ejemplo calculado:** con 200 pulsos/vuelta, 50 Hz equivalen a 15 RPM. La variable de rampa podría estar indicando aproximadamente 1 RPM durante ese arranque.

Recomiendo renombrar el dato como **`rpm_comandada`** o **`rpm_equivalente_STEP`**. Solo debe llamarse velocidad real si se mide.

### 3.7. El manejo de errores LEDC no es suficiente

En `begin()` no se comprueban todos los resultados. En `tick()`, si falla la frecuencia, se sigue con `ledcWrite(..., 512)`.

La API documenta que `ledcAttach()` y `ledcWrite()` pueden fallar, y que `ledcChangeFrequency()` devuelve cero cuando no configura la frecuencia. Esos retornos tienen que afectar al estado operativo, no únicamente a `_fActual`. [Espressif LEDC](https://docs.espressif.com/projects/arduino-esp32/en/latest/api/ledc.html)

**Respuesta requerida ante fallo:** solicitar inhibición, cortar STEP, enclavar un estado de error y no seguir anunciando régimen estable.

### 3.8. No se ha demostrado la compatibilidad GPIO-DM860

**La conexión directa de GPIO de 3,3 V a las entradas del DM860 no queda validada por el expediente.**

Un manual de DM860 consultado especifica señales nominales de 5 V y corriente de entrada de 7 a 16 mA. Otra variante, DM860T V3.0, exige niveles de 4,5-5 V o 24 V y documenta tiempos particulares de habilitación. No corresponde extrapolar automáticamente estas especificaciones a tu unidad, pero sí muestran por qué hace falta identificar el driver exacto. [Manual DM860](https://uelectronics.com/wp-content/uploads/2020/12/DMA860H-Driver-Manual.pdf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) [Manual DM860T V3.0](https://www.omc-stepperonline.com/download/DM860T_V3.0.pdf)

Antes de accionar:

- **Identificar modelo y fabricante exactos**, incluyendo configuración de entrada y microstepping.
- **Verificar nivel y corriente** en PUL, DIR y ENA; instalar interfaz adaptadora si corresponde.
- **Comprobar físicamente la polaridad de ENA**, sin deducirla solo del nombre de los bornes.
- **Verificar el estado durante encendido y reset**, cuando el firmware todavía no controla los GPIO.
- **Disponer de parada física independiente** del navegador y del programa.

Poner duty cero significa **dejar de enviar pasos**. No significa necesariamente liberar el motor: el driver puede mantener corriente y par de retención.

### 3.9. No están demostrados los tiempos garantizados de parada

La rampa está atendida después de:

```cpp
dnsServer.processNextRequest();
server.handleClient();
```

Una respuesta HTTP lenta puede retrasar el control. El periférico LEDC continúa generando pulsos mientras el programa atiende otras tareas.

`yield()` no ejecuta automáticamente `bomba.tick()`.

Por tanto:

- **70 RPM/s** es una pendiente nominal del algoritmo.
- **Menos de 1,5 s** no está garantizado desde el clic del operador.
- **Menos de 1 ms** no está demostrado para el sistema completo.
- La detección `_falloAlimentacion` es **diagnóstica**: no está conectada a un interbloqueo.

Para un banco supervisado no hace falta convertir el proyecto en un sistema industrial, pero sí retirar las garantías no medidas y no depender del Wi-Fi para detenerlo.

## 4. Concurrencia, metrología y registro: revisión adicional
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
