enzoocorte/Planta-Ultrafiltracion/02_Hito2_Instrumentacion_Sensores/02_Firmware_Test_Sensores/subhito2_2_v5/AuditoriaIA/RESPUESTA_ASTRA_RONDA10_PROPUESTA_V5_2.md

**Rechazo la aprobación final de esta V5.2 para la campaña experimental tal como está.** Sí tiene sentido compilarla como parte de la depuración, pero compilar correctamente no demostraría que sea segura ni metrológicamente válida.

Revisé los diez archivos proporcionados mediante análisis estático; **no ejecuté una compilación ni pruebas sobre hardware**. Este dictamen es una revisión técnica, no una certificación profesional de la instalación. Encontré errores concretos que contradicen varias afirmaciones del expediente.

## 1. La calibración cargada desde NVS vuelve a marcarse como documentada

Este es un **hallazgo bloqueante de trazabilidad** y demuestra que la observación 3 de la matriz no está resuelta.

En `cargarParametrosNVS()` se ejecuta:

```cpp
sensorAlimentacion.setK(ka);
```
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
