enzoocorte/Planta-Ultrafiltracion/02_Hito2_Instrumentacion_Sensores/01_Guias_Montaje_y_Calibracion/Simulaciones_Filtro_RC/curva_calidad_filtro_caudalimetro.png

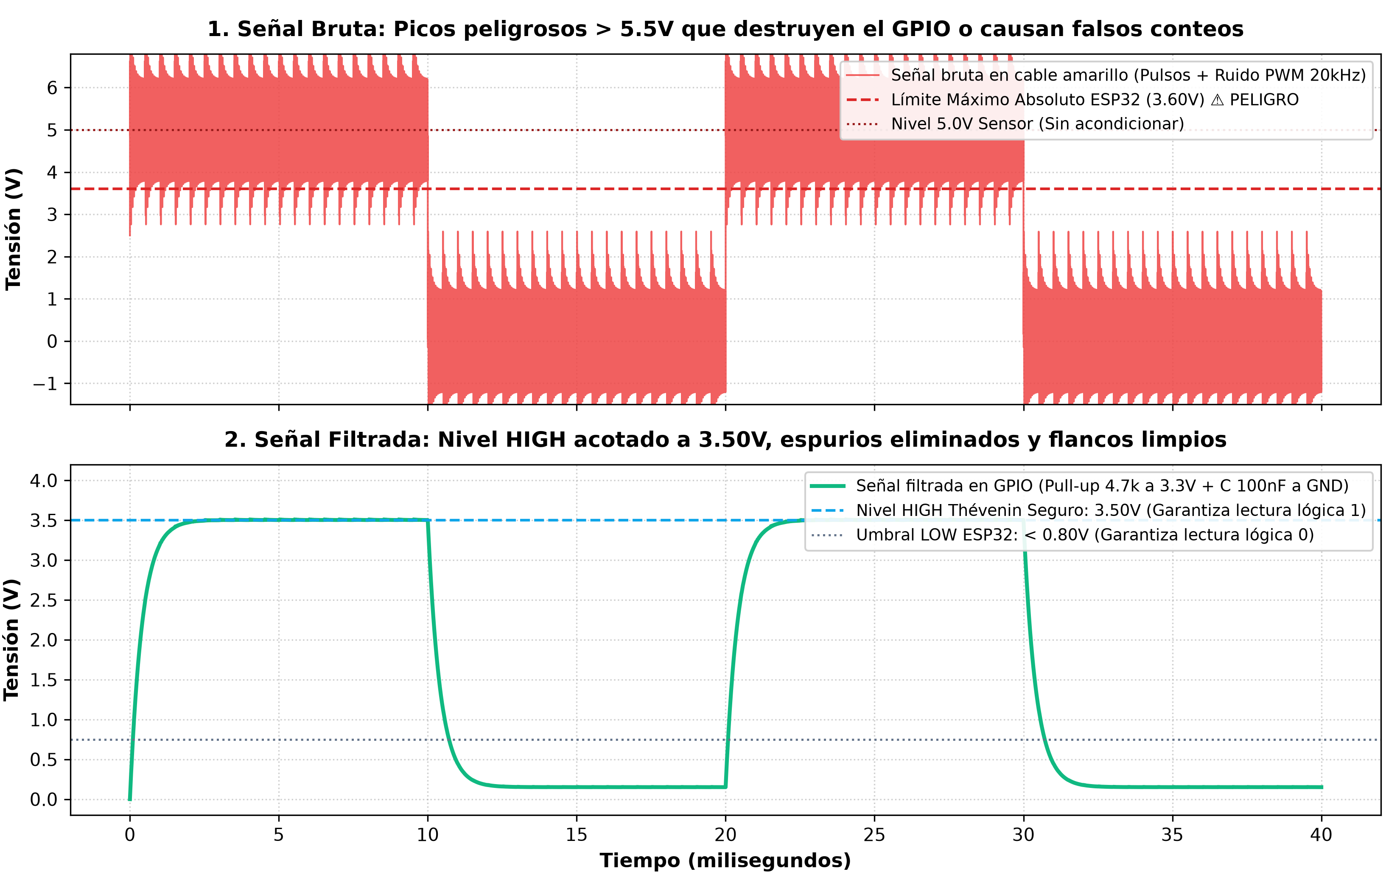
02_Hito2_Instrumentacion_Sensores/01_Guias_Montaje_y_Calibracion/Simulaciones_Filtro_RC/curva_calidad_filtro_caudalimetro.png
