enzoocorte/Planta-Ultrafiltracion/02_Hito2_Instrumentacion_Sensores/01_Guias_Montaje_y_Calibracion/Bitacoras_Calibracion/bitacora_2026-09-25.md

# 📘 BITÁCORA DIARIA DE ENSAYOS Y VERSIONES: 25/09/2026
**Proyecto:** Planta Piloto de Ultrafiltración FX100 • Hito 2 (Instrumentación y Control)  
**Tesistas:** Owen Cañizares & Antonella Guitián  
**Directores:** Dr. Ing. Jorge E. Almazán & Ing. Enzo M. Corte  
**Ubicación de Firmware:** `D:\ANTIGRAVITY\projects\antigravity-pipeline\TESIS\codigo_arduino\`  

---

## 📦 CONTROL DE VERSIONES DEL DÍA

### 🔹 Versión 1: `v1_2026-09-25` *(Superada)*
* **Directorio:** [`codigo_arduino/v1_2026-09-25/`](file:///D:/ANTIGRAVITY/projects/antigravity-pipeline/TESIS/codigo_arduino/v1_2026-09-25/v1_2026-09-25.ino)
* **Estado:** Puesta en marcha inicial, rampa suave (8 RPM/s) y cerrojos FreeRTOS validados.

### 🔹 Versión 2: `v2_2026-09-25` *(Superada)*
* **Directorio:** [`codigo_arduino/v2_2026-09-25/`](file:///D:/ANTIGRAVITY/projects/antigravity-pipeline/TESIS/codigo_arduino/v2_2026-09-25/v2_2026-09-25.ino)
* **Estado:** Primera aproximación asumiendo sensores en serie ($K=752$).

### 🔹 Versión 3: `v3_2026-09-25` *(ACTUAL - Calibración Completa en Régimen Tangencial)*
* **Directorio:** [`D:\ANTIGRAVITY\projects\antigravity-pipeline\TESIS\codigo_arduino\v3_2026-09-25\`](file:///D:/ANTIGRAVITY/projects/antigravity-pipeline/TESIS/codigo_arduino/v3_2026-09-25/v3_2026-09-25.ino)
* **Archivo Principal Arduino:** `v3_2026-09-25.ino`
* **Calibración Final:**
  - **FEED (Alimentación Bomba):** $512\text{ mL}$ en $30\text{ s} \implies Q_{\text{FEED}} = 1024.0\text{ mL/min}$ ($K_{\text{FEED}} = 110.06$).
  - **PERMEADO (Filtración Membrana):** $150\text{ mL}$ en $60\text{ s} \implies Q_{\text{PERM}} = 150.0\text{ mL/min}$ ($K_{\text{PERM}} = 110.45$).
  - **RETENTADO Calculado:** $Q_{\text{RET}} = 1024 - 150 = 874.0\text{ mL/min}$.
  - **Recuperación ($Y\%$):** $Y = \frac{150}{1024} \times 100 = 14.65\%$ *(Régimen tangencial óptimo)*.
  - **Cilindrada Bomba:** $\text{ML\_POR\_VUELTA} = \frac{1024}{72} = 14.222\text{ mL/vuelta}$.

---

## 🎯 OBJETIVOS DE LA SESIÓN DE HOY
1. Sincronizar el firmware con las últimas mejoras del repositorio de Enzo Corte (`subhito2_2_v2`).
2. Resolver el problema de ausencia de pulsos en el caudalímetro de permeado (GPIO 27).
3. Eliminar los golpes de par, vibraciones y ruido fuerte del motor NEMA 34 al arrancar e invertir.
4. Establecer una estructura de control de versiones separada por día y versión (`v1`, `v2`, etc.).

---

## 🚨 ERRORES ENCONTRADOS Y DIAGNÓSTICO TÉCNICO

### 1. Error de Lectura en Sensor de Permeado (GPIO 27)
* **Síntoma:** El sensor en GPIO 27 marcaba permanentemente `0.0 mL/min` a pesar de que el cableado tenía continuidad física perfecta.
* **Causa Raíz:** 
  - La etapa de salida del sensor YF-S401 es un transistor NPN en **colector abierto (Open-Collector)**. Al no tener resistencia *pull-up*, la línea quedaba en alta impedancia (flotante).
  - El caudal ensayado estaba por debajo de la velocidad mínima de rotación ($300\text{ mL/min}$).
* **Solución de Ingeniería Aplicada:**
  - Se conectó una **resistencia externa pull-up de $10\text{ k}\Omega$** entre la línea de señal (cable amarillo / GPIO 27) y el pin de **$3.3\text{ V}$** del ESP32.
  - Se fijó la velocidad mínima de consigna a **72 RPM** ($302.4\text{ mL/min}$).

### 2. Error en la Ecuación de Caudal ($\text{mL/min}$)
* **Síntoma:** El volumen integrado no coincidía con el aforo en probeta.
* **Causa Raíz:** Existía una división sobrante por 60 en la fórmula que convertía a $\text{mL/s}$.
* **Solución:** Corrección matemática a $Q(\text{mL/min}) = \frac{F_{\text{Hz}} \times 1000}{K}$.

### 3. Ruido Acústico Fuerte y Choque Mecánico en el Motor NEMA 34
* **Síntoma:** Ruido de golpe seco ("clunk") al encender, parar o invertir sentido.
* **Causa Raíz:** Aceleración muy abrupta ($40\text{ RPM/s}$) y salto discontinuo de frecuencia a $133\text{ Hz}$ (5 RPM) contra la inercia del cabezal y la rigidez de la manguera de silicona de 18 mm.
* **Solución de Ingeniería:**
  - Aceleración reducida a **$8.0\text{ RPM/s}$** (de 0 a 72 RPM en 9 segundos progresivos).
  - Desaceleración controlada a **$12.0\text{ RPM/s}$** (de 72 a 0 RPM en 6 segundos).
  - Generación de pulsos suave desde **$1.0\text{ RPM}$** ($26.6\text{ Hz}$).

### 4. Conflicto de Redefinición de Símbolos en Arduino IDE (`redefinition of PIN_PUL / setup / loop`)
* **Síntoma:** Error de compilación en Arduino IDE: `error: redefinition of 'const uint8_t PIN_PUL'`, `redefinition of void setup()`, `redefinition of void loop()`.
* **Causa Raíz:** En Arduino IDE, **todos los archivos con extensión `.ino` que se encuentren en la misma carpeta son compilados juntos** como un único programa. Al coexistir `2026-09-07_V1.ino` (código antiguo) y `codigo_arduino.ino` en la carpeta raíz, el compilador intentaba fusionar ambos sketches encontrando dobles definiciones de pines y funciones `setup()` / `loop()`.
* **Solución de Ingeniería Aplicada:**
  - Se eliminó el archivo suelto duplicado de la raíz (dejando el original resguardado en su subcarpeta `codigo_arduino/2026-09-07_V1/`).
  - Se aisló el código actual en la subcarpeta versionada [`codigo_arduino/v1_2026-09-25/v1_2026-09-25.ino`](file:///D:/ANTIGRAVITY/projects/antigravity-pipeline/TESIS/codigo_arduino/v1_2026-09-25/v1_2026-09-25.ino), cumpliendo la regla estricta de Arduino IDE (1 solo archivo `.ino` principal por carpeta).

### 5. Desincronización de Caché de Compilación tras Actualización de Paquete ESP32 (`esp32-hal.h: No such file`)
* **Síntoma:** Error en Arduino IDE: `HardwareSerial.h: fatal error: .../3.3.11/cores/esp32/esp32-hal.h: No such file or directory`.
* **Causa Raíz:** El Gestor de Tarjetas de Arduino IDE actualizó en segundo plano el paquete de placas de `3.3.11` a `3.3.12` (`esp32:esp32-libs@3.3.12 instalado`). La carpeta `3.3.11` fue eliminada por el instalador pero el proceso en ejecución de Arduino IDE mantenía en caché las rutas hacia `3.3.11`.
* **Solución de Ingeniería Aplicada:**
  - Se purgó la caché temporal de compilación de Arduino IDE en `AppData\Local\arduino\sketches\*`.
  - Se confirmó la integridad del nuevo paquete `3.3.12` con `esp32-hal.h`.
  - Solución para el usuario: Reiniciar Arduino IDE para recargar el árbol de dependencias actualizado.

### 6. Descalibración de Caudalímetros YF-S401 y Cilindrada de Bomba (`Q=1150 mL/min vs Real=150 mL/min`)
* **Síntoma:** A 72 RPM, el dashboard web marcaba $1150.1\text{ mL/min}$ en FEED ($112.7\text{ Hz}$) y $1154.5\text{ mL/min}$ en PERMEADO ($113.1\text{ Hz}$).
* **Ensayo Experimental de Validación:** En un ensayo con probeta graduada a 72 RPM durante exactamente $1\text{ minuto}$ ($60\text{ s}$), se recolectó un volumen real de:
  $$V_{\text{real}} = 150\text{ mL} \implies Q_{\text{real}} = 150\text{ mL/min} = 0.150\text{ L/min}$$
* **Causa Raíz:**
  1. El factor $K = 98.0\text{ pulsos/L}$ era un valor nominal de catálogo que no correspondía con los pulsos de alta resolución de las turbinas YF-S401 utilizadas en el banco de pruebas.
  2. El volumen por vuelta teórico ($4.2\text{ mL/rev}$) sobreestimaba la cilindrada real de la bomba con la manguera de silicona bajo pérdida de carga.
* **Cálculos y Solución de Ingeniería Aplicada (Versión `v2_2026-09-25`):**
  1. **Cálculo del Factor $K$ real del sensor:**
     $$K_{\text{FEED}} = \frac{F_{\text{FEED}}}{Q_{\text{real}}} = \frac{112.7\text{ Hz}}{0.150\text{ L/min}} = \mathbf{751.3}\text{ pulsos/L}$$
     $$K_{\text{PERM}} = \frac{F_{\text{PERM}}}{Q_{\text{real}}} = \frac{113.1\text{ Hz}}{0.150\text{ L/min}} = \mathbf{754.0}\text{ pulsos/L}$$
  2. **Cálculo de la Cilindrada Real de la Bomba:**
     $$\text{ML\_POR\_VUELTA} = \frac{150\text{ mL/min}}{72\text{ RPM}} = \mathbf{2.0833}\text{ mL/vuelta}$$
* **Resultado:** Con estos parámetros calibrados, $Q_{\text{FEED}} = 150.0\text{ mL/min}$, $Q_{\text{PERM}} = 150.0\text{ mL/min}$, $Q_{\text{bomba}} = 150.0\text{ mL/min}$ y $\Delta = 0.0\%$.

---

## ✅ ÉXITOS Y RESULTADOS CONSOLIDADOS EN `v2_2026-09-25`
- [x] **Calibración gravimétrica exacta** con probeta a 72 RPM ($K_{\text{FEED}} = 751.3$, $K_{\text{PERM}} = 754.0$, $\text{Cilindrada} = 2.0833\text{ mL/rev}$).
- [x] Rango de RPM ajustado a 50–200 RPM en la interfaz SCADA.
- [x] Purgado de caché y sincronización exitosa con el nuevo Core ESP32 `3.3.12` en Arduino IDE.
- [x] Corrección de colisión de archivos `.ino` y aislamiento completo de versiones en carpetas individuales.
- [x] Arranque progresivo ultrasuave sin vibraciones ni ruidos de par en el motor NEMA 34.
- [x] Lectura estable de ambos sensores YF-S401 (FEED en GPIO 14 y PERM en GPIO 27).
- [x] Cerrojos atómicos FreeRTOS (`portMUX_TYPE`) para evitar condiciones de carrera entre el WebServer y las interrupciones ISR.
- [x] Dashboard web SCADA responsivo y funcional en `http://192.168.4.1`.
