enzoocorte/Planta-Ultrafiltracion/(commit log)

2026-09-09 Estructura inicial del proyecto en 6 Hitos modulares
    [plantilla_datos_ensayo_tesis.csv]
2026-09-09 Hito 1: Expansion exhaustiva de control de potencia NEMA 34 + DM860 + ESP32 con guia fisica y firmware
2026-09-09 Docs: Actualizacion de indice del README principal para Hito 1
2026-09-09 Estructura Definitiva: Manual General de Navegacion para Antonella y Owen, limpieza de raiz y actualizacion academica
2026-09-09 Hito 1: Puesta a punto y optimizacion de motor NEMA 34 8 cables (CNC Insumos FX3.162) y calibracion de switches DM860
2026-09-09 Hito 1: Modulo bomba peristaltica con control Wi-Fi, Web Dashboard, guia de bornera ESP32 y OTA
2026-09-09 Consolidacion definitiva: Unificacion de Hito 1 y 2 en 5 hitos maestros sin redundancias y actualizacion de manuales
    [plantilla_datos_ensayo_tesis.csv]
2026-09-10 Estructura completa de 5 hitos: solo README.md en raíz, subcarpetas ordenadas, entregables y checklists en cada documento
    [plantilla_datos_ensayo_tesis.csv]
2026-09-10 Clarificacion de firmwares en Hito 1: bomba.ino (Web/WiFi) vs Hito1_ControlMotor.ino (Serial)
2026-09-18 Agregando lugares de compra
2026-09-21 Hito 1: Firmware definitivo con control Web SCADA y documentacion de conexion Anodo Comun 5V
2026-09-21 Hito 1: Inversion suave con rampa de frenado, rango 60-200 RPM y alerta visual de caudal 0.60 L/min
2026-09-21 Hito 1: Rango operativo acotado a 70-160 RPM y presets (80, 100, 120, 140 RPM)
2026-09-22 Arquitectura General: Creacion de 00_General_y_P_ID_Planta con plano maestro ISA 5.1, evaluacion de ingenieria y simulador interactivo
2026-09-22 P&ID General: Detalles de conexion motor 12V L298N, montaje boya inox, valvula aguja manual y 4 canales ADS1115
2026-09-22 P&ID: Explicacion de tension 12V vs 5V para agitador y guia de acople mecanico de paleta
2026-09-22 docs y firmware: modularizacion subhito 2.1 caudalimetros y guia de construccion de tanques
2026-09-22 docs y firmware: ajuste de roles de caudalimetros (Q1 Feed vertical, Q2 Permeado horizontal)
2026-09-23 feat(subhito2.1): incorporar arquitectura modular planta_uf.ino y optimizaciones anti-ruido caudalimetros
    - Agrega arquitectura modular de 5 archivos en planta_uf.ino/ con clases Bomba y Caudalimetro
    - Corrige error de linker Xtensa GCC con portMUX_TYPE en caudalimetro.cpp
    - Configura driver DM860 en Cátodo Común (PUL+/DIR+ en P18/P19, GND común) para inmunidad EMI
    - Implementa triple defensa anti-ruido en caudalímetros YF-S401 (bloqueo 3ms, tope 700 mL/min, EMA 30/70)
    - Documenta adaptación de nivel de tensión de 4.2V a 3.3V y verificación de compilación exitosa con FlashMode=dio
    [Bomba.h, caudalimetro.cpp, caudalimetro.h, config.h, index_html.h, subhito2_1_caudalimetros.ino]
2026-09-23 refactor(hito2): reubicar firmware modular v2 en 02_Hito2_Instrumentacion_Sensores/02_Firmware_Test_Sensores/subhito2_2_v2
    - Mueve la arquitectura modular desde la raíz del repo a su ubicación canónica en Hito 2
    - Renombra el archivo principal a subhito2_2_v2.ino para cumplimiento estricto con Arduino IDE
    - Actualiza documentación y enlaces en Hito 2 README.md
    - Verifica compilación exitosa con FlashMode=dio
2026-09-24 fix(subhito2_2_v2): configurar arranque a 72 RPM y blindar conexion Wi-Fi con router Box804
    - Ajusta RPM_MIN y RPM_INICIO a 72.0 RPM (302.4 mL/min) para coincidir con el caudal minimo del YF-S401 (0.30 L/min)
    - Actualiza sliders y presets en la interfaz Web SCADA (72, 80, 100, 120, 140 RPM)
    - Implementa inicio de WiFi como cliente STA primero para fijar canal RF de Box804 antes de levantar SoftAP
    - Agrega rutina de reconexion automatica cada 30 segundos en el loop() si se cae el enlace con el router
    [config.h, index_html.h]
2026-09-24 fix(bomba): invertir polaridad de PIN_DIR para que arranque en sentido filtracion en catodo comun
    - Ajusta fijarSentido() en Bomba.h: LOW = filtracion (horario), HIGH = retrolavado (antihorario)
    - Resuelve la inversion fisica de sentido provocada por la transicion a catodo comun
    [Bomba.h]
2026-09-24 feat(ui): agregar etiqueta de unidad mL/min visible junto a los numeros grandes de caudal
2026-09-24 fix(caudalimetro): corregir calculo mL/min (remover /60), almacenar frecuencia fisica real en Hz y elevar umbral soplido
    [caudalimetro.h, config.h]
2026-09-25 fix(caudalimetro): atomic critical section in ISR and deterministic failure counter
    [caudalimetro.cpp, caudalimetro.h]
2026-09-25 docs: agregar manual tecnico y explicacion exhaustiva de firmware v2 para tesis
2026-09-25 docs: agregar ficha tecnica oficial bomba peristaltica MBP-2000 y analisis manguera 12mm
2026-09-25 feat: adaptar SCADA y firmware a 20-42 RPM (manguera 12mm) y agregar exportador CSV para Excel
2026-09-28 feat(hito2): acondicionamiento front-end antirruido, pull-up externo, filtro 12ms y control 20-100 RPM con alerta membrana
2026-09-28 docs(firmware): actualizar manual tecnico linea por linea y armonizar FILTRO_RUIDO_US a 3000 us (333 Hz)
2026-09-28 fix(firmware): corregir bug de bloqueo en inversion con setRPM, totalizador de volumen en else y documentar trade-off 12ms/4.5ms
    [Bomba.h, caudalimetro.h, config.h]
2026-09-28 fix(bomba): restaurar consigna huerfana en arrancar tras STOP durante inversion y tabla diagnostico P5
    [Bomba.h]
2026-09-28 fix(bomba): blindar maquina de estados con fallback a RPM_INICIO en arrancar y subtests P8a/P8b
    [Bomba.h]
2026-09-29 docs(manual): incorporar comentarios de Enzo (3 rodillos, probeta 1000ml, valvula retentado, fisica micropasos e impacto arquitectura)
2026-09-29 docs(hito3): agregar guia visual interactiva guia_conexion_sedimentador.html, fotos reales del motor 12V y driver L298N
2026-09-30 docs: actualizar README general con bitacora Git, enlaces SCADA y mapa de repositorio; feat: configurar 3200 pulsos/rev
2026-09-30 docs(tesis): diagnostico y resolucion de ruido EMI 81Hz, inversion de sensores y datasets CSV
    [datos_planta_uf_2026-09-30 (1).csv, datos_planta_uf_2026-09-30.csv]
2026-10-01 feat(capitulo4): unificar firmware de produccion de Owen con persistencia NVS, auto-calibracion, datalogger y seguridad FX100
    [CALIBRACION_CAUDALIMETROS_PROBETA_50RPM_72RPM.xlsx, ParametrosFiltroFX100.txt]
2026-10-01 refactor: reestructurar y distribuir material de Owen en sus hitos correspondientes y crear ORGANIZACION_PROYECTO_Y_EQUIPO.md
    [CALIBRACION_CAUDALIMETROS_PROBETA_50RPM_72RPM.xlsx]
2026-10-01 refactor(firmware): organizar en subhito2_2_v3/EN_USO_firmware_planta y actualizar documentacion
    [CALIBRACION_CAUDALIMETROS_PROBETA_50RPM_72RPM.xlsx]
2026-10-01 docs(fx100): integrar parametros tecnicos de membrana FX100 y actualizar prompt de auditoria externa
2026-10-01 feat(firmware): crear subhito2_2_v4 con correccion de inversion, conteo reciproco, eliminacion de fragmentacion heap, darcy.h, 100 RPM y prompt ronda 2
    [CALIBRACION_CAUDALIMETROS_PROBETA_50RPM_72RPM.xlsx]
2026-10-01 docs(prompt): enriquecer prompt ronda 2 con contexto completo fisico y hardware para sesiones sin memoria (ChatGPT Astra)
2026-10-01 fix(hardening): corregir rollover de micros, rearmado tras parada larga y diagnostico por tiempo segun auditoria ronda 2
    [Bomba.h, caudalimetro.cpp, caudalimetro.h]
2026-10-01 docs: consolidar Hoja de Ruta Maestra de Desarrollo (Hito 2.3 y 5) e integrar auditoria de IA en README
    - Creacion de HOJA_DE_RUTA_DESARROLLO_Y_ENSAYOS.md con especificaciones de adquisicion de transductores (0-1 bar, single-ended en ADS1115), seguridad fisica de desplazamiento positivo (valvula de alivio, parada dura, techo dinamico), arquitectura FreeRTOS determinista y protocolo experimental factorial 3x3 de Darcy (flujo critico Jc, compresibilidad coloidal y recuperacion).
    - Actualizacion de README.md principal incorporando mapa de ruta, sintesis ejecutiva de directrices tecnicas y enlaces directos.
    - Incorporacion de auditoria externa Ronda 2 de Claude Sonnet 5 en AuditoriaIA.
    - Actuali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
2026-10-02 docs: crear PROMPT_AUDITORIA_RONDA3_CLAUDE_OPUS.md para cierre de fase de revision tecnica
2026-10-02 docs: integrar dictamen de auditoria Ronda 3 de Claude 5.5 Opus y resolver bloqueantes criticos
    - Incorporacion de ronda3_claude_opus.md en AuditoriaIA con veredicto Aprobado Condicionado.
    - Resolucion del Bloqueante 1: Calibracion de valvula de alivio a 0.70 bar y software trip P1 a 0.60 bar (evita destruir membrana con alivio previo a 1.0 bar).
    - Resolucion del Bloqueante 2: Evaluacion de enclavamientos de sobrepresion y TMP a 50 ms (20 Hz) incondicional en tareaControl.
    - Resolucion del Bloqueante 3: Incorporacion de balanza de precision en laboratorio como estandar primario de permeado (YF-S401 opera bajo su rango util de 300 mL/min).
    - Resolucion del Bloqueante 4: Recirculacion obligato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
2026-10-02 feat(v4): endurecimiento metrológico de caudalímetros, cota física, aclaración unidades K y manual técnico línea por línea
2026-10-02 docs(v4): agregar guia de cambios implementados y protocolo de pruebas de banco paso a paso
2026-10-02 feat(v4): agregar planilla Excel automatizada para Ensayos 2 y 3 (probeta 1000 mL y regresión lineal)
    [PLANILLA_CALIBRACION_ENSAYOS_2_Y_3.xlsx]
2026-10-02 docs(audit): agregar prompt maestro de auditoria final para GPT Astra (Ronda 4)
2026-10-02 docs(audit): incluir todo el codigo fuente del firmware v4 en el prompt de Astra
2026-10-02 docs(audit): incorporar hoja de ruta de la tesis y eje de deteccion de blind spots en prompt de Astra
2026-10-02 docs(audit): dictamen Ronda 4 + arnes de verificacion en host del caudalimetro v4
    Cierra la cuarta ronda de auditoria tecnica del firmware v4 antes del banco
    de calibracion del lunes.
    No se modifica ningun archivo del firmware: el codigo esta bajo certificacion
    y los hallazgos se entregan como dictamen con las correcciones propuestas en
    forma de parche textual.
    Contenido:
    1. AuditoriaIA/Ronda4_GPT_Astra_Dictamen_Final.md
    Dictamen APROBADO CONDICIONADO con 4 bloqueantes, 9 hallazgos altos,
    7 medios y 6 no-issues cerrados. Todos los resultados numericos citados
    provienen de lecturas del repositorio o de la ejecucion del arnes.
    2. verificacion_host/
    Arnes que compila y ejecuta c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
2026-10-02 fix(firmware): blindaje v4 tras auditoria ronda 4 (GLM 5.3 y GPT Astra)
    - caudalimetro.cpp: cambiar pinMode a INPUT (respeta pull-up 4.7k a 3.3V de Placa 2)
    - config.h: acotar Q_MAX_FISICO_MLMIN a 2500 mL/min (filtro activo anti-ruido EMI) y clarificar tiempo de frenado
    - darcy.h: corregir Rm nominal a 2.09e13 m^-1 segun ISO 8637 (K_UF especificado a 37 C)
    - EN_USO_firmware_planta.ino: desactivar auto-calibracion ficticia de permeado; hacer qp opcional en calibracion bypass; silenciar datalogger al presionar STOP para eliminar muestras espurias
    - PLANILLA_CALIBRACION_ENSAYOS_2_Y_3.xlsx: vaciar celdas sinteticas de entrada para registro experimental real
    - AuditoriaIA: incluir dictamen de aud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
    [PLANILLA_CALIBRACION_ENSAYOS_2_Y_3.xlsx]
2026-10-02 refactor(firmware): blindaje integral de interfaz web SCADA y buffers JSON
    - index_html.cpp: hacer opcional el caudal de permeado en calibracion manual web para operar en bypass sin alertas espurias
    - EN_USO_firmware_planta.ino: acotar longitud de buffer snprintf en handleStatus para evitar sobrelecturas
    - EN_USO_firmware_planta.ino: elevar umbral de recuperacion Y a qAlim > 50 mL/min para filtrar valores espurios en reposo
2026-10-05 docs(excel): sincronizar copia limpia de planilla en raiz de subhito2_2_v4
    [PLANILLA_CALIBRACION_ENSAYOS_2_Y_3.xlsx]
2026-10-05 feat(wifi): agregar DNS Captive Portal para evitar desconexiones en Android, iOS y Windows
2026-10-07 docs y calibracion: actualizar planillas y notas de calibracion v4 e incorporar modulo de estructura para filtro
    [PLANILLA_CALIBRACION_ENSAYOS_2_Y_3.xlsx, PlantaUF_Calibracion_HistoricoCompleto (APP).csv]
2026-10-08 docs(scada): manual de operacion, balance hidraulico y calibracion v4
2026-10-08 fix(datalogger): muestreo a 1 Hz y registro garantizado de corrida al parar bomba
    [EN_USO_firmware_planta.ino, config.h]
2026-10-08 fix(calibracion): blindaje EMI con INPUT_PULLUP, corte deadband, datalogger a 10s y segmentacion automatica por RPM
    [EN_USO_firmware_planta.ino, caudalimetro.cpp, config.h]
2026-10-08 docs(audit): crear prompt maestro de Auditoria Ronda 5 para validacion experimental y blindaje de caudalimetros
2026-10-08 fix(firmware-v4): blindaje metrologico y datalogger segun auditoria Ronda 5
    - Caudalimetros: filtro de coherencia temporal anti-rafagas EMI, rechazo de dispersion dt_max/dt_min y corte por caudal minimo cuantificable.
    - Datalogger: reemplazo de desplazamiento FIFO por Buffer Circular Indexado O(1) en RAM sin copia continua.
    - SCADA: blindaje contra saturacion de ensayos en handleSetRPM y columna Estable_1_0 en CSV para discriminar rampas dinamicas de regimen estacionario.
    - Bomba: incorporacion de parada de emergencia fisica con PIN_ENA y frenado rapido < 1.5s (70 RPM/s).
    - Modelo Darcy: acotamiento estricto de temperatura 5-60 C, validacion finita y renombrado a R_adicional.
    - Auditoria: in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
    [Bomba.cpp, Bomba.h, EN_USO_firmware_planta.ino, caudalimetro.cpp, caudalimetro.h, config.h, darcy.h]
2026-10-08 docs(auditoria): agregar prompt maestro de auditoria Ronda 6 para certificacion de Subhito 2.2 con hardware congelado y mejoras de software
2026-10-09 docs(prompt-ronda6): exigir propuesta de codigo C++ completo y funcional a cada auditor de IA
2026-10-09 feat(subhito2.2): Motor V5 Anti-EMI con validacion de ancho de pulso, diagnostico en seco y resolucion de Ronda 6
    [EN_USO_firmware_planta.ino, caudalimetro.cpp, caudalimetro.h]
2026-10-09 feat(subhito2.2_v5): Estructura oficial V5, prompt maestro Ronda 7 y protocolo de pruebas
    [CALIBRACION_CAUDALIMETROS_PROBETA_50RPM_72RPM.xlsx, PLANILLA_CALIBRACION_ENSAYOS_2_Y_3.xlsx, PlantaUF_Calibracion_HistoricoCompleto (APP).csv]
2026-10-09 fix(v5): Integracion de mejoras de auditoria GPT Astra (Ronda 7), aserciones de pines y precision de 64 bits
    [EN_USO_firmware_planta.ino, caudalimetro.cpp, caudalimetro.h, config.h, registro_ensayos.h]
2026-10-09 feat(scada): Redireccion 302 automatica para apertura instantanea del SCADA al conectar al Wi-Fi
2026-10-09 docs(v5): Guia completa de laboratorio y prompt maestro Ronda 8 para aprobacion final de Astra
2026-10-09 docs(v5): Actualizacion de guia de laboratorio con datos validados de Ensayos 2 y 3 y anticipo de manometros
2026-10-09 docs(prompt): Permitir rechazo explicito demandando codigo funcional con cambios necesarios para aprobar
2026-10-09 fix(permeado): Eliminar retencion de periodo espurio, doble captura y actualizar K en tiempo real segun dictamen Astra Ronda 9
    [EN_USO_firmware_planta.ino, caudalimetro.cpp, caudalimetro.h, registro_ensayos.h]
2026-10-09 docs(subhito2_2): actualizar protocolo y guia de ensayos en laboratorio a Firmware V5.2 definitivo
2026-10-10 Implementar rutina de banco y ajuste temporal qMin
2026-10-13 feat(scada): agregar botones modo seco, ajuste fino +/- para factor K y boton de metrologia 29 cols
2026-10-13 fix(calibracion): igualar K_PERMEADO nominal a 196.50 (YF-S401) y clarificar protocolo en guia de laboratorio
2026-10-13 feat(scada): agregar simulador HTML interactivo pedagogico y Paso 0 de compilacion/flasheo en guias
2026-10-13 fix(scada): Redisenar seccion de calibracion por probeta con 3 tarjetas etiquetadas y dinamizar resaltado de botones RPM
2026-10-13 feat(auditoria): Generar expediente completo definitivo V5.2 y resolver hallazgos metrologicos de exportacion y tara de volumen
2026-10-13 fix(firmware): Corregir bug JS lbl_kp, lectura atomica de 64 bits en tara, trazabilidad NVS y control de sesiones activas
2026-10-13 feat(subhito2.2): incorporacion dictamen Astra Ronda 11, proteccion de sesiones, tara por epoca y banco de calibracion serial
2026-10-13 feat(scada): permitir calibracion por probeta con bomba en marcha o detenida transmitiendo frecuencias estables observadas
2026-10-13 fix(startup): mover asignacion de Fila a begin() en setup para evitar fallo de memoria OOM en app_startup de FreeRTOS
2026-10-15 wip(firmware-v6.4): fix RPM=0 bug & add 3000us/mediana3 filter; flow reading pending physical screw-terminal rewiring on Board 2
2026-10-15 fix(caudalimetro): corregir cuello de botella de software en v6.4 (blanking 1200us para pulsacion peristaltica, corte 600Hz y filtro resiliente)
2026-10-16 feat: reestructuracion integral de hitos, manometros glicerina en SCADA Darcy, control Opuntia, modelos Hermia/SEM y nuevo Hito 6 OPEX/SEC
2026-10-16 refactor: ordenamiento integral de hitos 0 a 6, eliminacion de archivos sueltos y actualizacion de readmes
2026-10-16 docs: sinceramiento riguroso del estado de avance fisico de los hitos 0 a 6 y cuellos de botella de taller
2026-10-19 docs: actualizar memoria tecnica para reactor de 25L, guia de torque agitador, analisis manometro beyca y dip switch sw4
2026-10-19 docs: prompt formal de consulta a Argon para seleccion y montaje del agitador de 25L
2026-10-19 docs: actualizar prompt de consulta a Argon con observacion del tecnico y arquitectura 1 vs 2 ESP32
2026-10-19 refactor: normalizar nombre subhito2_2_v6 a minusculas para orden alfabetico tras v5 y agregar banner de acceso rapido en README
2026-10-19 feat(hito3): incorporar dictamen tecnico de Argon para agitador 25L (motor 5840-31ZY/limpiaparabrisas, chumacera KFL08, driver BTS7960 43A, manguera GX16-4 y lista de compras)
2026-10-20 feat(firmware): incorporar firmware V6.5 de produccion a main (DS18B20 1-Wire, Heap Datalogger, 50 RPM, SCADA dinamico y esquemas)
2026-10-20 fix(firmware-v6.5): integrar hallazgos de auditoria Argon (corte fisico ENA en paradaEmergencia, retardo TIEMPO_ENA_MS en tick y filtro anti-parpadeo DS18B20)
2026-10-20 docs(firmware-v6.5): agregar manual tecnico pedagogico y explicacion linea por linea para los tesistas
2026-10-26 feat(firmware): integrar V6.6 con entrada directa de RPM en SCADA, correccion de SoftAP en Core 3.x, parada por limites filtrada y gestion robusta de ensayos
    - Integra panel general mobile-first y dial tactil de Owen (commits 1446760 y fa63dd1)
    - Agrega campo de entrada numerica directa de RPM exactas en la interfaz SCADA con boton Aplicar y tecla Enter
    - Corrige secuencia de inicializacion de SoftAP para Core ESP32 v3.3.12 (eliminando WiFi.disconnect y llamando softAP de forma limpia)
    - Corrige persistencia de RPM de inicio en Bomba.h/cpp al cambiar configuracion con bomba detenida
    - Incorpora filtro de persistencia (3 segundos consecutivos) en parada automatica por limites de proceso para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
2026-10-26 docs: formalizar prompt de consulta a Argon para skid 45x45, compras y mecanizado inox
2026-10-26 docs: actualizar prompt maestro de Argon para incluir contexto completo, enlace a repo y 4 ejes de auditoria
2026-10-27 feat: incorporar observaciones criticas de Argon (tabique divisor skid, puertos FX100, lista compras y blindaje EMI)
2026-10-27 fix(firmware+skid): aplicar correcciones criticas de Bomba, buffer circular y DS18B20; actualizar maletin a 50x35x35 con fachada exterior
2026-10-27 fix(firmware): solucionar rampa de parada suave en Bomba, reset de cronometro de ensayo y sincronizacion de espejos
2026-10-27 docs: formalizar orden de trabajo para herreria de fabricacion del maletin 500x350x350
